konpdan25/Arduino_Spot_Welder_V4/DIY_SPOT_WELDER_V1/Reports/ERC/SCHEMATIC_CONNECTIVITY_CHECK.txt

DIY_SPOT_WELDER_V1 - schematic connectivity check (custom script, NOT KiCad ERC)
Netlist: Reports/Validation/DIY_SPOT_WELDER_V1_kicad7_export.net (kicad-cli 7.0.11 sch export netlist)

[1] Parity: kicad-cli exported netlist vs. design.py (on-board parts)
  nets compared: 64, on-board components: 133
  RESULT: PASS

[2] Rule checks on the full design (incl. off-board power assembly and PWR_FLAGs)
  nets checked: 75

SUMMARY: 0 error(s), 0 warning(s)
Note: a clean result proves netlist consistency only - it is NOT an electrical or safety approval.
