konpdan25/Arduino_Spot_Welder_V4/DIY_SPOT_WELDER_V1/Reports/DRC/DRC_REPORT_KiCad7.txt

** Drc report for /home/user/Arduino_Spot_Welder_V4/DIY_SPOT_WELDER_V1/KiCad/DIY_SPOT_WELDER_V1.kicad_pcb **
** Created on 2026-10-12 07:38:45 **

** Found 94 DRC violations **
[silk_overlap]: Silkscreen overlap
    Rule: board setup constraints silk; Severity: warning
    @(64.8648 mm, 130.7650 mm): Line on F.Silkscreen
    @(65.5750 mm, 132.7250 mm): Reference 'C3'
[silk_overlap]: Silkscreen overlap
    Rule: board setup constraints silk; Severity: warning
    @(64.9048 mm, 130.7650 mm): Line on F.Silkscreen
    @(65.5750 mm, 132.7250 mm): Reference 'C3'
[silk_overlap]: Silkscreen overlap
    Rule: board setup constraints silk; Severity: warning
    @(64.9448 mm, 130.7650 mm): Line on F.Silkscreen
    @(65.5750 mm, 132.7250 mm): Reference 'C3'
[silk_overlap]: Silkscreen overlap
    Rule: board setup constraints silk; Severity: warning
    @(64.9848 mm, 130.7650 mm): Line on F.Silkscreen
    @(65.5750 mm, 132.7250 mm): Reference 'C3'
[silk_overlap]: Silkscreen overlap
    Rule: board setup constraints silk; Severity: warning
    @(65.0248 mm, 130.7650 mm): Line on F.Silkscreen
    @(65.5750 mm, 132.7250 mm): Reference 'C3'
[silk_overlap]: Silkscreen overlap
    Rule: board setup constraints silk; Severity: warning
    @(65.0648 mm, 130.7650 mm): Line on F.Silkscreen
    @(65.5750 mm, 132.7250 mm): Reference 'C3'
[silk_overlap]: Silkscreen overlap
    Rule: board setup constraints silk; Severity: warning
    @(65.1048 mm, 130.7650 mm): Line on F.Silkscreen
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
    @(234.9800 mm, 68.1900 mm): PTH pad 2 [GND] of J3
[starved_thermal]: Thermal relief connection to zone incomplete (zone min spoke count 2; actual 1)
    Local override; Severity: error
    @(50.6000 mm, 50.6000 mm): Zone [GND] on B.Cu
    @(131.5850 mm, 121.7750 mm): PTH pad 2 [GND] of C16
[starved_thermal]: Thermal relief connection to zone incomplete (zone min spoke count 2; actual 1)
    Local override; Severity: error
    @(50.6000 mm, 50.6000 mm): Zone [GND] on B.Cu
    @(131.5850 mm, 165.2250 mm): PTH pad 2 [GND] of C20
[starved_thermal]: Thermal relief connection to zone incomplete (zone min spoke count 2; actual 1)
    Local override; Severity: error
    @(50.6000 mm, 50.6000 mm): Zone [GND] on F.Cu
    @(131.5850 mm, 126.0250 mm): PTH pad 2 [GND] of C18
[starved_thermal]: Thermal relief connection to zone incomplete (zone min spoke count 2; actual 1)
    Local override; Severity: error
    @(50.6000 mm, 50.6000 mm): Zone [GND] on F.Cu
    @(199.1950 mm, 68.2450 mm): PTH pad 5 [GND] of U4
[silk_edge_clearance]: Silkscreen clipped by board edge
    Rule: board setup constraints silk; Severity: warning
    @(50.0000 mm, 190.0000 mm): Line on Edge.Cuts
    @(50.0450 mm, 70.0050 mm): Reference 'J1'

** Found 1 unconnected pads **
[unconnected_items]: Missing connection between items
    Local override; Severity: error
    @(156.0300 mm, 184.9750 mm): Track [ENC_SW_RAW] on B.Cu, length 1.1769 mm
    @(113.0750 mm, 169.4750 mm): PTH pad 1 [ENC_SW_RAW] of R27

** Found 0 Footprint errors **

** End of Report **
