konpdan25/Arduino_Spot_Welder_V4/DIY_SPOT_WELDER_V1/Reports/Validation/CALCULATION_RESULTS.md

# Calculation results (generated by `Calculations/Engineering_Models/weld_calc.py`)

> All values are **estimates** derived from the parameter table. None are measurements.

## 1. Parameters

| Key | min | typ | max | unit | origin |
|---|---|---|---|---|---|
| bat_ocv | 12.4 | 12.7 | 12.9 | V | ASM  open-circuit voltage 75 %..100 % SoC |
| bat_rint | 0.025 | 0.032 | 0.045 | ohm | DS3 <=32 mOhm (full charge, 25 C, AC method); DC pulse value assumed up to 45 mOhm |
| bat_imax_ds | 70 | 70 | 70 | A | DS3 max discharge current 70 A for 5 s |
| car_rint | 0.004 | 0.006 | 0.009 | ohm | ASM  45-60 Ah, 400-600 A EN starter battery |
| len_batlead_m | 0.5 | 0.6 | 0.8 | m | ASM  total length battery(+)->assembly + assembly->battery(-) |
| len_weld_m | 0.8 | 1 | 1.2 | m | ASM  total length of both welding cables |
| cs_cable_mm2 | 16 | 16 | 16 | mm2 | ASM  16 mm2 fine-stranded silicone (as reference) |
| r_tips | 0.0001 | 0.00015 | 0.00025 | ohm | ASM  2 solid Cu electrodes ~40 mm, 10 mm2 |
| n_joints | 6 | 8 | 10 | - | ASM  bolted/crimped joints in the loop |
| r_joint | 5e-05 | 0.0001 | 0.0002 | ohm | ASM  per clean crimp/bolt joint |
| r_fuse | 0.0003 | 0.00045 | 0.0007 | ohm | ASM  ANL/MIDI 100-150 A cold resistance (verify with fuse datasheet) |
| r_relay | 0.0002 | 0.0006 | 0.0015 | ohm | ASM  unknown used 100 A relay contacts (MUST be measured) |
| r_disconnect | 0.0001 | 0.00015 | 0.0003 | ohm | ASM  battery isolator switch |
| r_weld | 0.0005 | 0.0015 | 0.003 | ohm | ASM  electrode-Ni-cell contact + Ni path; falls during the weld |
| n_fet | 6 | 6 | 6 | - | STOCK at least 6 x IRLZ44N |
| rds_25 | 0.022 | 0.022 | 0.022 | ohm | DS  RDS(on) max at VGS=10 V, ID=25 A, Tj=25 C |
| rds_tc | 1.45 | 1.6 | 1.75 | x | DS  normalised RDS(on) at Tj~125 C read from curve (approx.) |
| share | 1.1 | 1.2 | 1.3 | x | ASM  worst-device current share factor for 6 parallel TO-220 |
| r_fet_leads | 5e-05 | 8e-05 | 0.00012 | ohm | ASM  per device leads+solder to busbar |
| fet_idm | 160 | 160 | 160 | A | DS  pulsed drain current |
| fet_rthjc | 1.8 | 1.8 | 1.8 | K/W | DS  RthJC TO-220 (IRLZ44N) |
| zth_tau | 0.4 | 0.3 | 0.2 | s | ASM  Zth(t) ~ RthJC*sqrt(t/tau) (min=best); fit to typical TO-220 curves, verify on real datasheet |
| tj_limit | 150 | 150 | 150 | C | DESIGN derated junction limit for repetitive pulses |
| fet_tjmax | 175 | 175 | 175 | C | DS |
| t_case | 35 | 50 | 65 | C | ASM  drain busbar/heatsink temperature |
| l_weld | 4e-07 | 9e-07 | 1.5e-06 | H | ASM  welding cables (kept together vs. open loop) |
| l_bat | 1e-07 | 2e-07 | 4e-07 | H | ASM  battery leads, twisted, short |
| c_logic_uF | 7200 | 9000 | 10800 | uF | STOCK 6800 uF + 2200 uF / 25 V, +-20 % |
| c_relay_uF | 11760 | 14700 | 17640 | uF | STOCK 10000 uF + 4700 uF / 25 V, +-20 % |
| i_logic | 0.06 | 0.08 | 0.11 | A | ASM  Nano ~25 mA + OLED 20 mA + 7805/LDO Iq + LM393 + TC4422 Iq + LEDs |
| i_relay | 0.27 | 0.3 | 0.33 | A | USER ~300 mA relay coil at 12 V |
| r_tap | 1.5 | 1.5 | 1.5 | ohm | DESIGN inrush/limit resistor in supply tap |
| vf_supply | 0.35 | 0.45 | 0.55 | V | DS  SB560/1N5822-class Schottky at ~0.4 A |
| uvlo_th | 7.8 | 8 | 8.2 | V | DESIGN gate-drive UVLO threshold |
| v_7805_min_in | 7 | 7 | 7 | V | DS  7805 min input at light load (Vout+2 V) |
| pl_R | 67320 | 68000 | 68680 | ohm | DESIGN 1 % |
| pl_C | 8e-07 | 1e-06 | 1.1e-06 | F | DESIGN 1 uF X7R 50 V 1206, incl. DC-bias derating |
| pl_voh | 4.6 | 4.8 | 5 | V | DS  ATmega328P VOH at ~1 mA, VCC 4.8-5.2 V |
| fw_max_on_ms | 50 | 50 | 50 | ms | DESIGN firmware hard limit for one ON interval |

## 2. Loop resistance budget (mOhm)

| Element | best | typ | worst |
|---|---|---|---|
| battery leads | 0.54 | 0.64 | 0.86 |
| welding cables | 0.86 | 1.07 | 1.29 |
| electrode tips | 0.10 | 0.15 | 0.25 |
| joints | 0.30 | 0.80 | 2.00 |
| fuse | 0.30 | 0.45 | 0.70 |
| relay contacts | 0.20 | 0.60 | 1.50 |
| disconnect | 0.10 | 0.15 | 0.30 |
| MOSFETs (6x IRLZ44N, hot) | 5.33 | 5.88 | 6.44 |
| weld zone | 0.50 | 1.50 | 3.00 |
| **R_ext total** | **8.22** | **11.25** | **16.34** |

## 3. Weld current envelope

| Source | Case | R_source mOhm | R_ext mOhm | I_peak A | V_terminal during pulse V | P_weld-zone W | E_weld-zone in 10 ms J |
|---|---|---|---|---|---|---|---|
| RT1270 | best | 25.0 | 8.22 | 388 | 3.19 | 75 | 0.75 |
| RT1270 | typ | 32.0 | 11.25 | 294 | 3.30 | 129 | 1.29 |
| RT1270 | worst | 45.0 | 16.34 | 202 | 3.30 | 123 | 1.23 |
| Car battery (ref.) | best | 4.0 | 3.90 | 1633 | 6.37 | 1334 | 13.34 |
| Car battery (ref.) | typ | 6.0 | 6.37 | 1027 | 6.54 | 1581 | 15.81 |
| Car battery (ref.) | worst | 9.0 | 10.90 | 623 | 6.79 | 1165 | 11.65 |

Ratio of weld-zone power car/RT1270 (typ): **12.2x**. RT1270 typical current is **4.2x** the datasheet 70 A (5 s) maximum.

## 4. MOSFET single-pulse stress (6x IRLZ44N, worst-shared device)

Zth(t) = RthJC*sqrt(t/tau) capped at RthJC (assumption). Current held constant (conservative).

| Total current A | Case | T_case C | I per device A | IDM margin | Tj after 20 ms | Tj after 50 ms | Tj after 100 ms | Max pulse for Tj<=150 C |
|---|---|---|---|---|---|---|---|---|
| 200 | best | 35 | 37 | 4.4x | 48 C | 56 C | 67 C | 1000 ms |
| 200 | typ | 50 | 40 | 4.0x | 71 C | 85 C | 104 C | 244 ms |
| 200 | worst | 65 | 43 | 3.7x | 102 C | 132 C | 178 C | 70 ms |
| 294 | best | 35 | 54 | 3.0x | 65 C | 87 C | 116 C | 165 ms |
| 294 | typ | 50 | 59 | 2.7x | 101 C | 146 C | 222 C | 53 ms |
| 294 | worst | 65 | 64 | 2.5x | 171 C | 326 C | runaway | 15 ms |
| 388 | best | 35 | 71 | 2.2x | 94 C | 144 C | 226 C | 54 ms |
| 388 | typ | 50 | 78 | 2.1x | 163 C | 320 C | runaway | 17 ms |
| 388 | worst | 65 | 84 | 1.9x | runaway | runaway | runaway | 5 ms |
| 450 | best | 35 | 82 | 1.9x | 121 C | 209 C | 393 C | 30 ms |
| 450 | typ | 50 | 90 | 1.8x | 239 C | runaway | runaway | 10 ms |
| 450 | worst | 65 | 98 | 1.6x | runaway | runaway | runaway | 3 ms |

Conclusion basis: the firmware ON-time limit must stay below the 'typ' max-pulse column at the expected current.

## 5. Average dissipation (repetition)

- One weld every 2 s, 65 ms total ON: 8.5 J/device/weld -> 4.3 W/device, 26 W total into the drain busbar/heatsink.
- One weld every 5 s, 65 ms total ON: 8.5 J/device/weld -> 1.7 W/device, 10 W total into the drain busbar/heatsink.
- One weld every 10 s, 65 ms total ON: 8.5 J/device/weld -> 0.9 W/device, 5 W total into the drain busbar/heatsink.

## 6. Inductive energy at turn-off

- I = 294 A: welding-cable energy 65 mJ (free-wheels through STPS3045CP), battery-lead energy 17 mJ (absorbed by 1000 uF + SMBJ24CA at the assembly bus).
- I = 388 A: welding-cable energy 113 mJ (free-wheels through STPS3045CP), battery-lead energy 30 mJ (absorbed by 1000 uF + SMBJ24CA at the assembly bus).
- Free-wheel time constant ~0.40 ms; I2t per diode die (2 dice share) ~7.6 A2s vs. 242 A2s for 220 A/10 ms half-sine (DS3 IFSM).

## 7. Control rail hold-up (diode-isolated banks)

Worst-case bank voltage before the pulse: 11.19 V (OCV min - Vf max - I*R_tap).

| Rail | C used uF (min) | Load A (max) | ON time ms | Droop V | End voltage V | Limit |
|---|---|---|---|---|---|---|
| Logic + gate drive | 7200 | 0.11 | 65 | 0.99 | 10.20 | UVLO 8.2 V, 7805 7.0 V |
| Relay coil | 11760 | 0.33 | 65 | 1.82 | 9.37 | relay drop-out voltage UNKNOWN |
| Logic + gate drive | 7200 | 0.11 | 96 | 1.47 | 9.72 | UVLO 8.2 V, 7805 7.0 V |
| Relay coil | 11760 | 0.33 | 96 | 2.69 | 8.50 | relay drop-out voltage UNKNOWN |

(65 ms = firmware maximum ON time: 50 ms main + 15 ms pre-pulse; second row = upper bound of the hardware limiter per ON interval.)

Inrush at connection: peak 8.6 A, energy in R_tap 2.37 J, I2t 1.58 A2s (choose a T3.15 A fuse with I2t >> this value).

## 8. Hardware pulse-length limiter window (Monte-Carlo, 20 000 samples)

R = 68 kOhm 1 %, C = 1 uF (-20/+10 %), Vth = VCC x 22k/(10k+22k), VCC 4.8-5.2 V, VOH VCC-0..0.2 V, LM393 Vos 5 mV.

- Hardware limit: min **63 ms**, median 78 ms, max **96 ms**.
- Firmware limit per ON interval: 50 ms -> margin to HW minimum 13 ms.

## 9. ADC scaling

- VBAT / VELEC / VDRV / VHOLD / VDRAIN: divider 33k/10k, k = 4.30; full scale 21.5 V at AVCC=5 V (21.0 mV/LSB), 4.73 V with the 1.1 V internal reference (4.6 mV/LSB); source impedance 7.7 kOhm.
- V_DS at typical current: 1723 mV -> current estimate from V_DS has +-30 % uncertainty (RDS(T) spread). It is an indication, not a measurement.

## 10. Cable adiabatic short-circuit withstand

- 10 mm2: I2t = 1.32 MA2s -> 9 s at 388 A
- 16 mm2: I2t = 3.39 MA2s -> 22 s at 388 A
- 25 mm2: I2t = 8.27 MA2s -> 55 s at 388 A

Weld-pulse I2t through the main fuse (best case 388 A, 65 ms): 9.8 kA2s per weld -> compare with the fuse's PRE-ARCING I2t (datasheet); require pre-arc I2t >= 5x pulse I2t to avoid fatigue.
