konpdan25/Arduino_Spot_Welder_V4/DIY_SPOT_WELDER_V1/Reports/Validation/DIY_SPOT_WELDER_V1_schematic.pdf

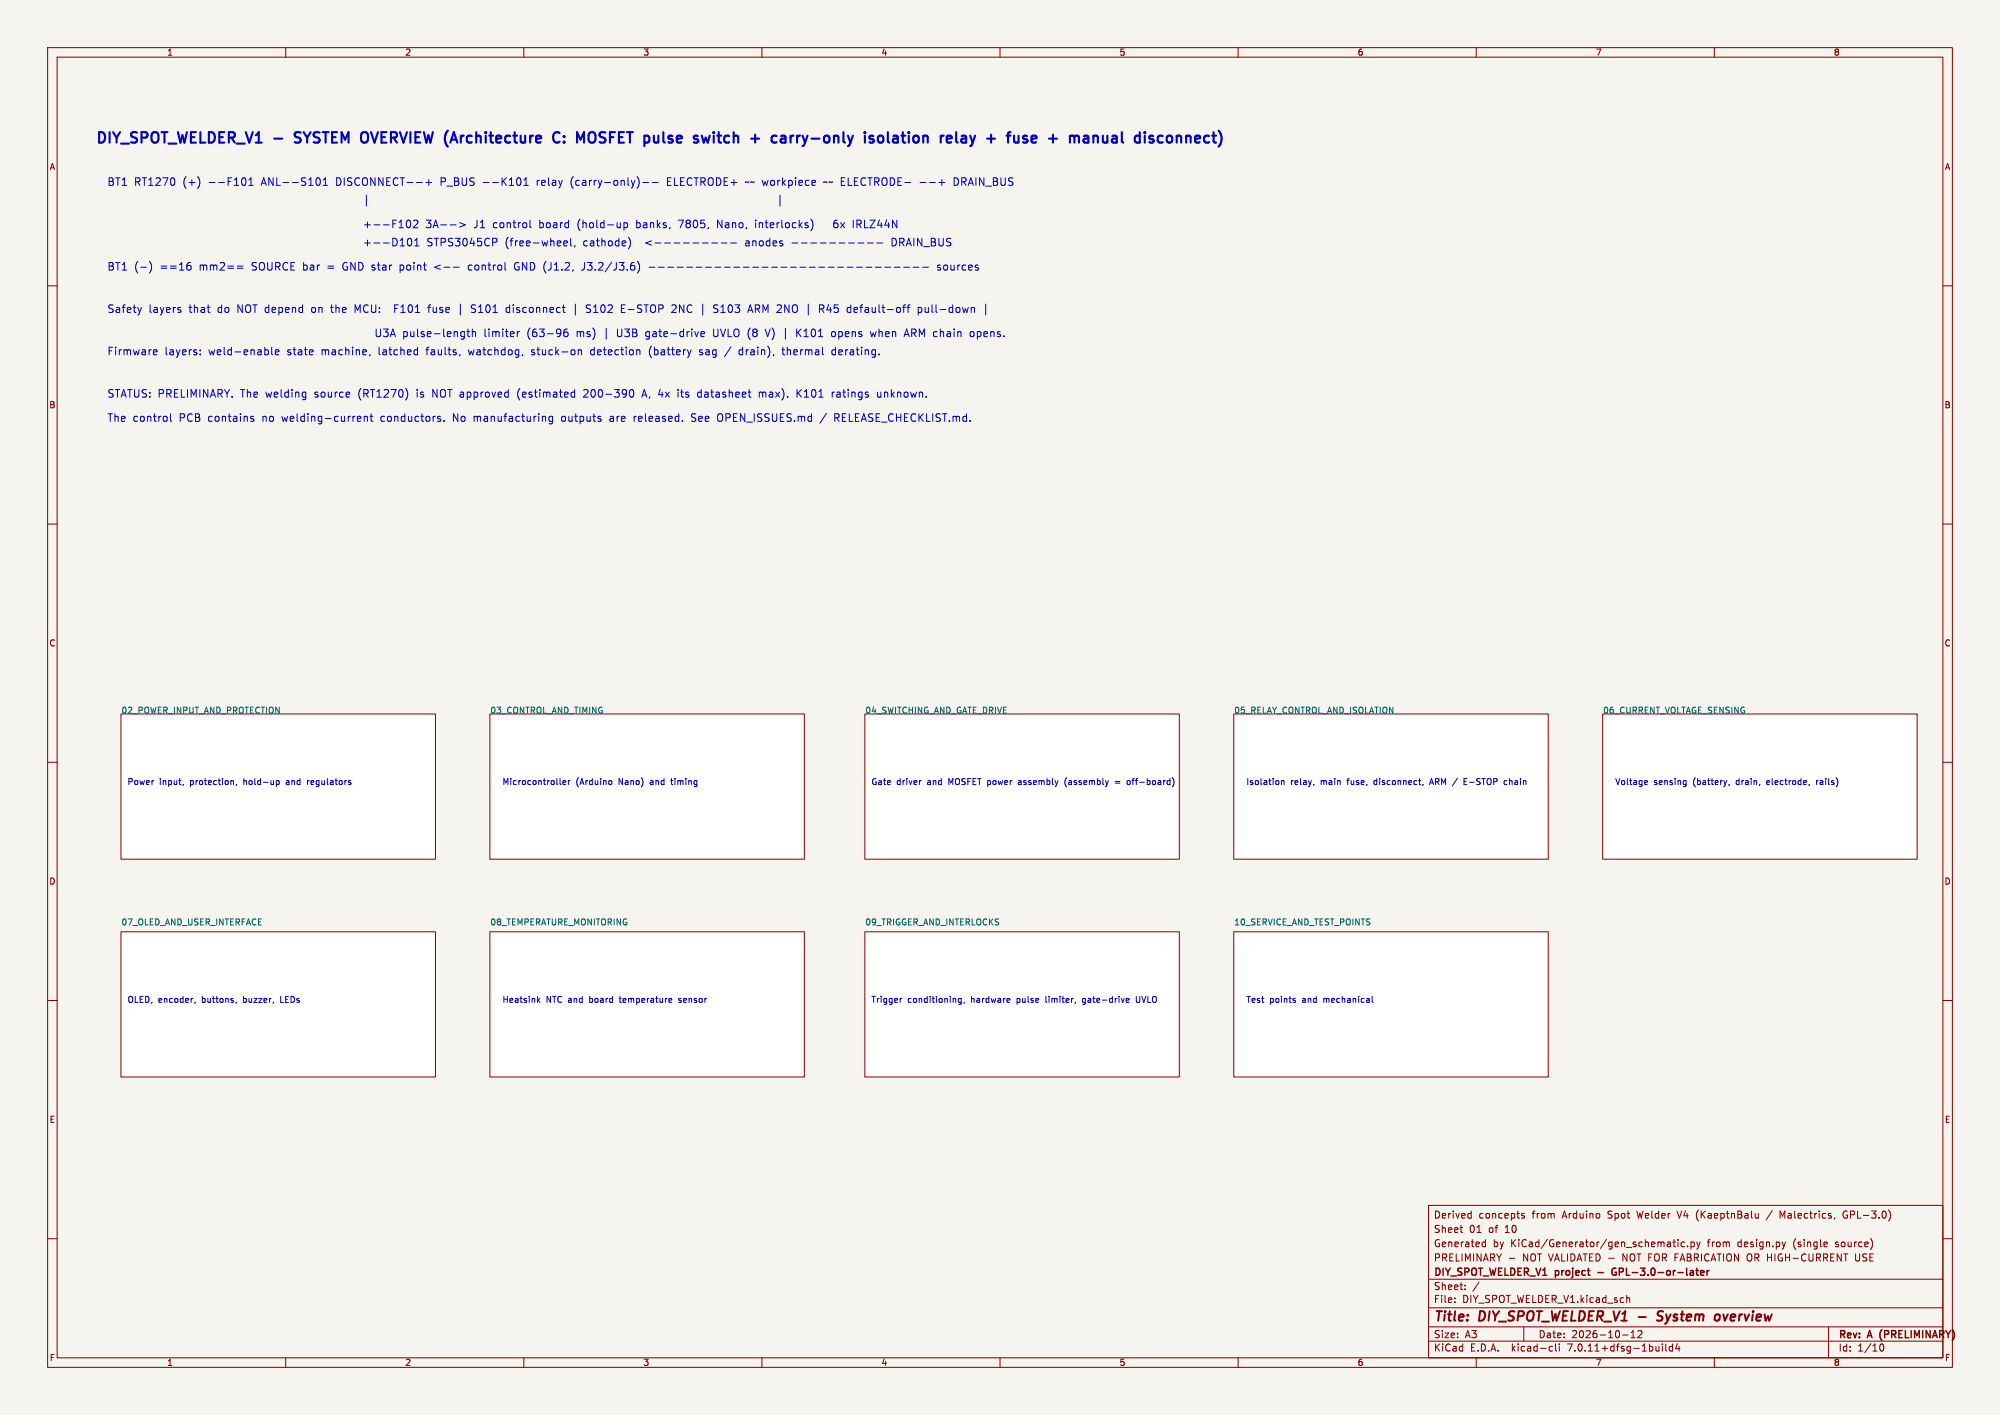
[picture p1: page 1]

Id: 1/10 Title: DIY_SPOT_WELDER_V1 - System overview

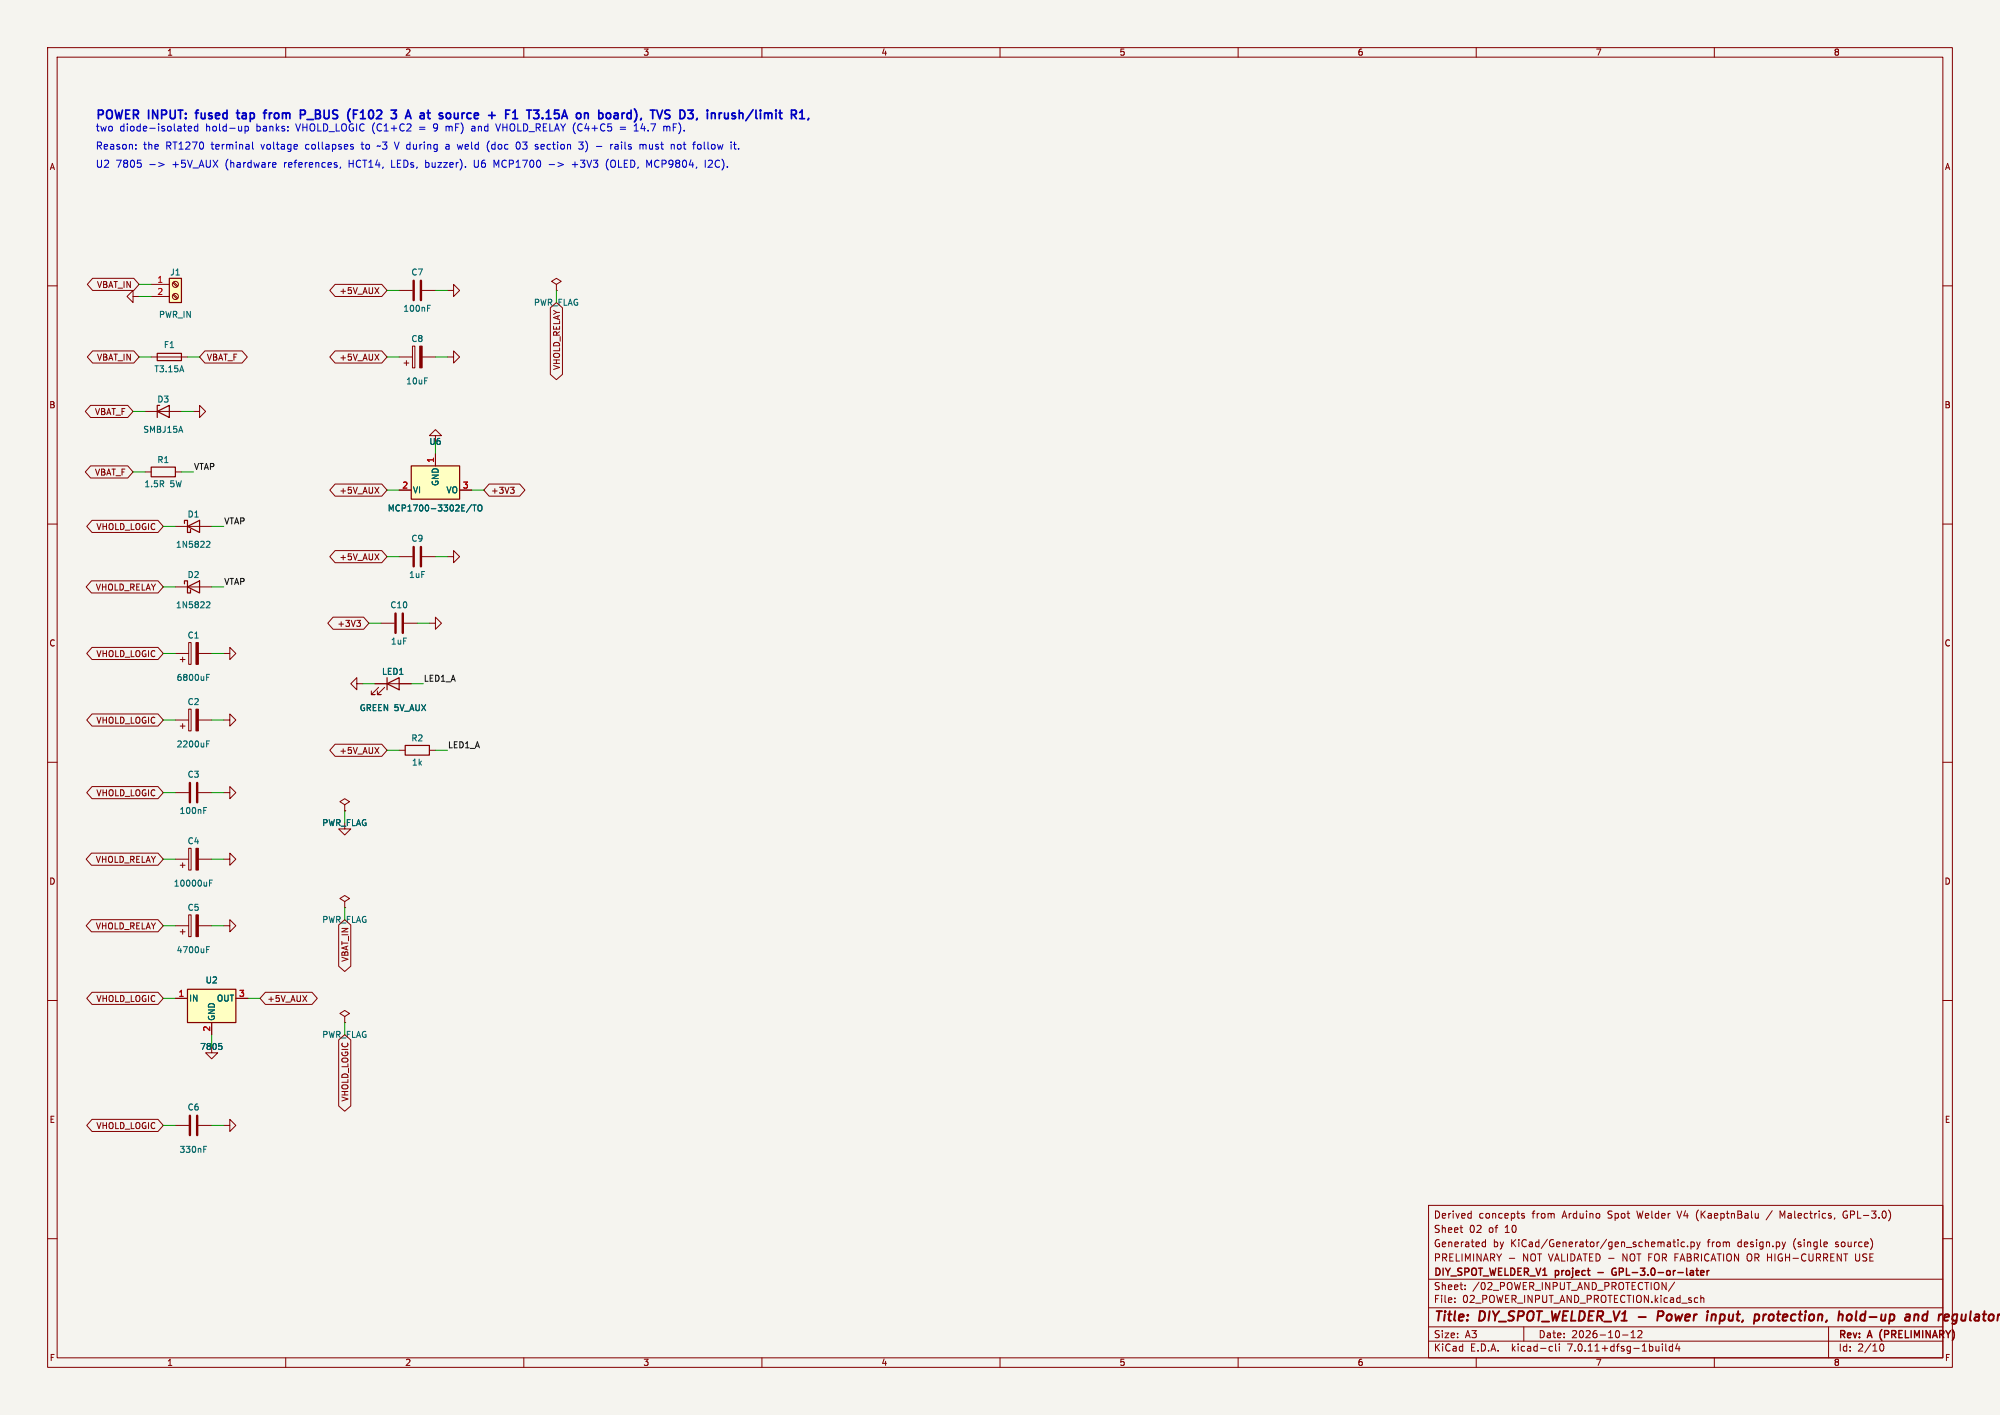
[picture p2: page 2]

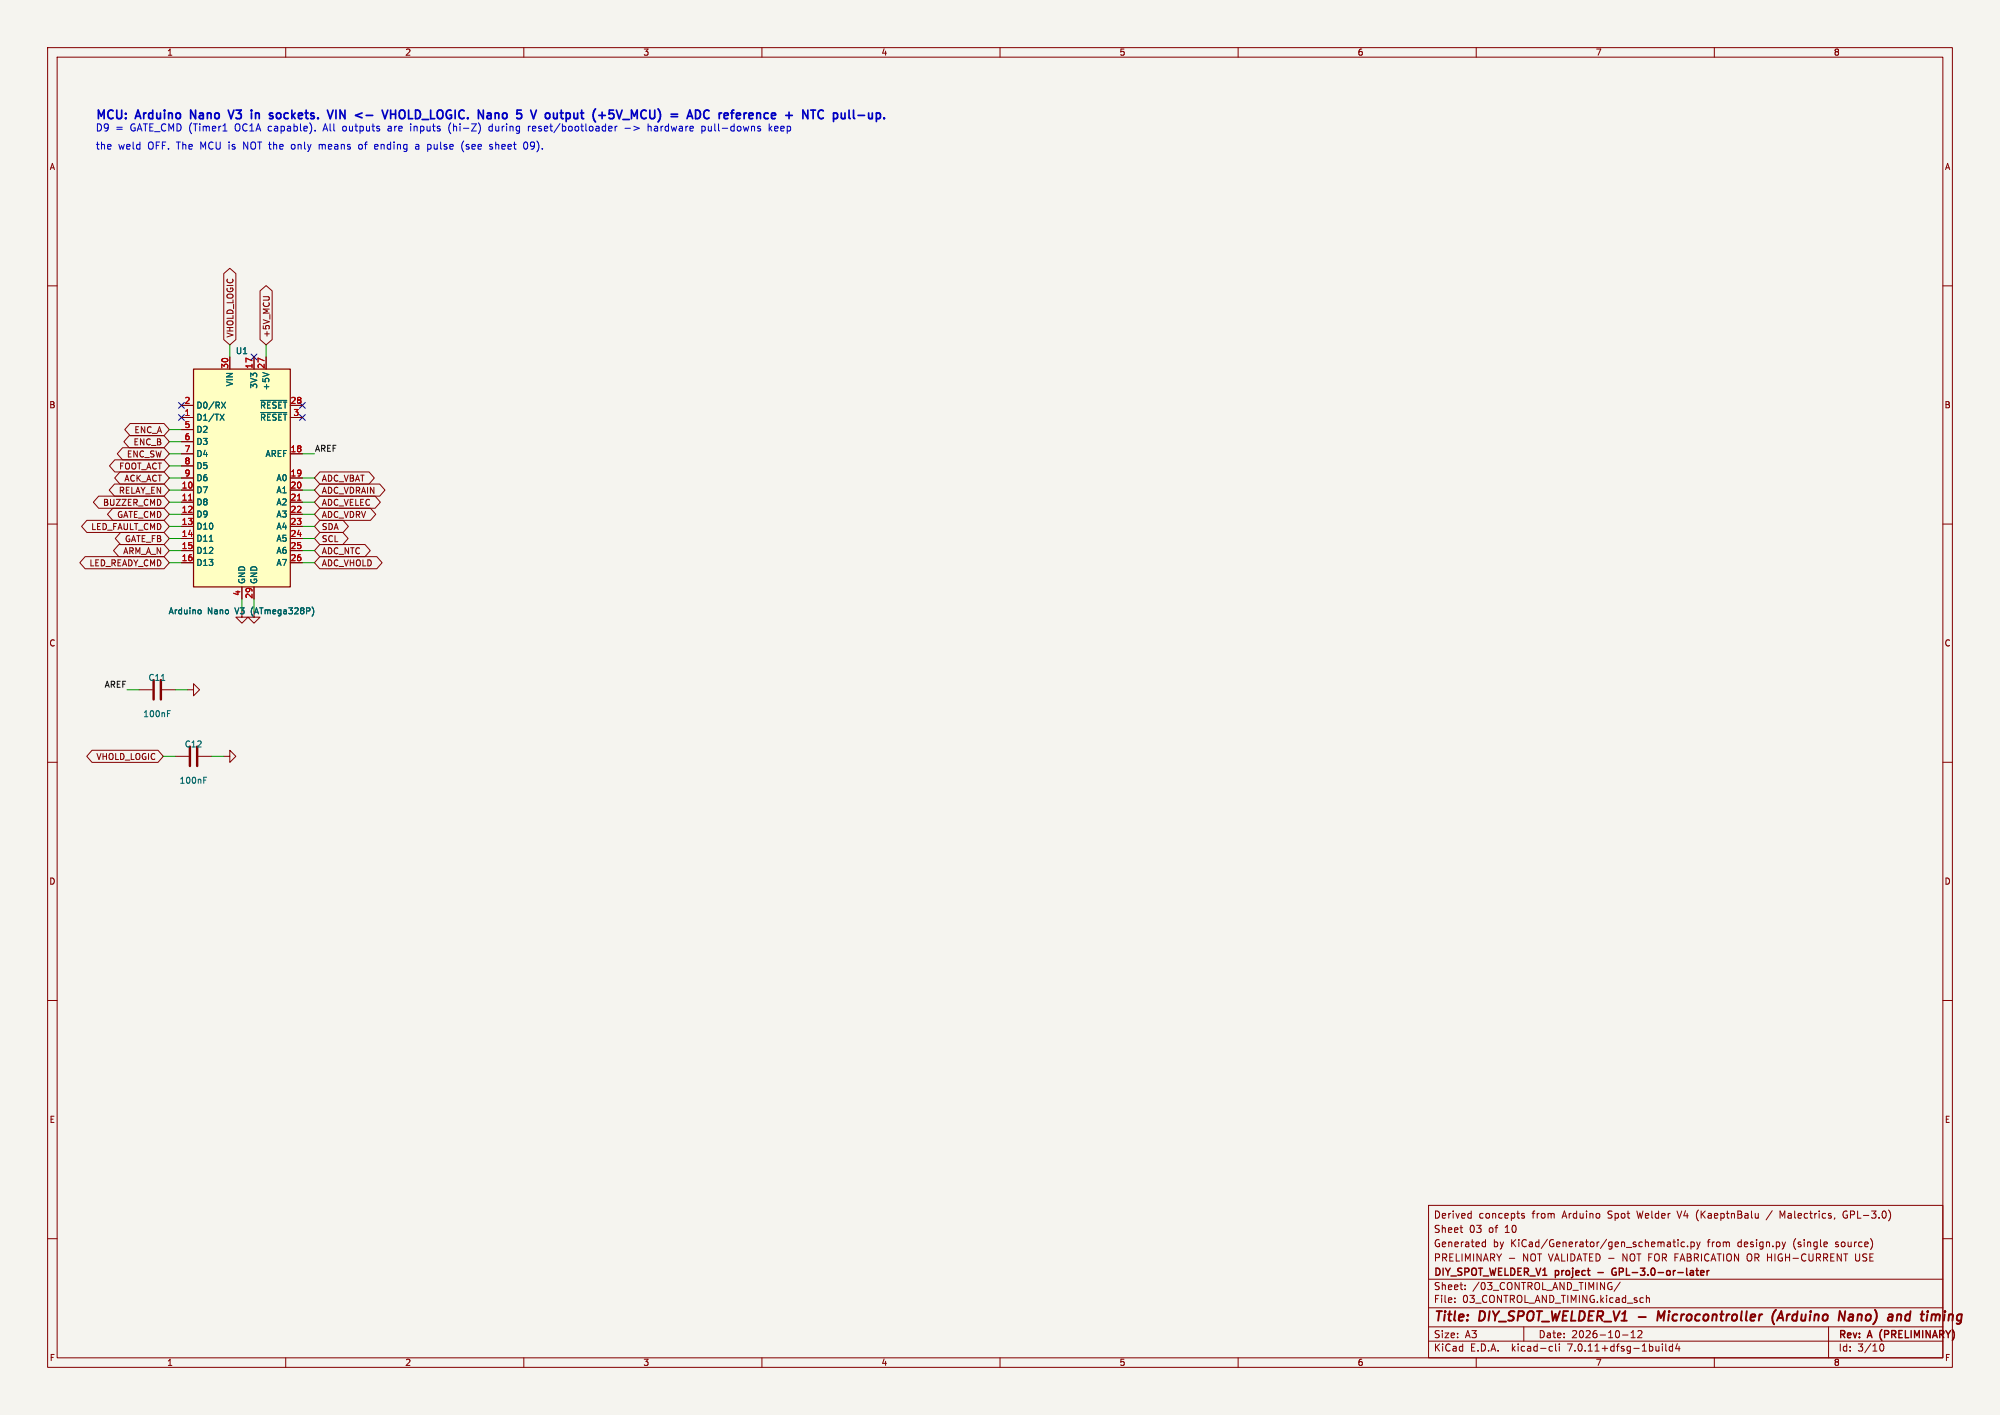
[picture p3: page 3]

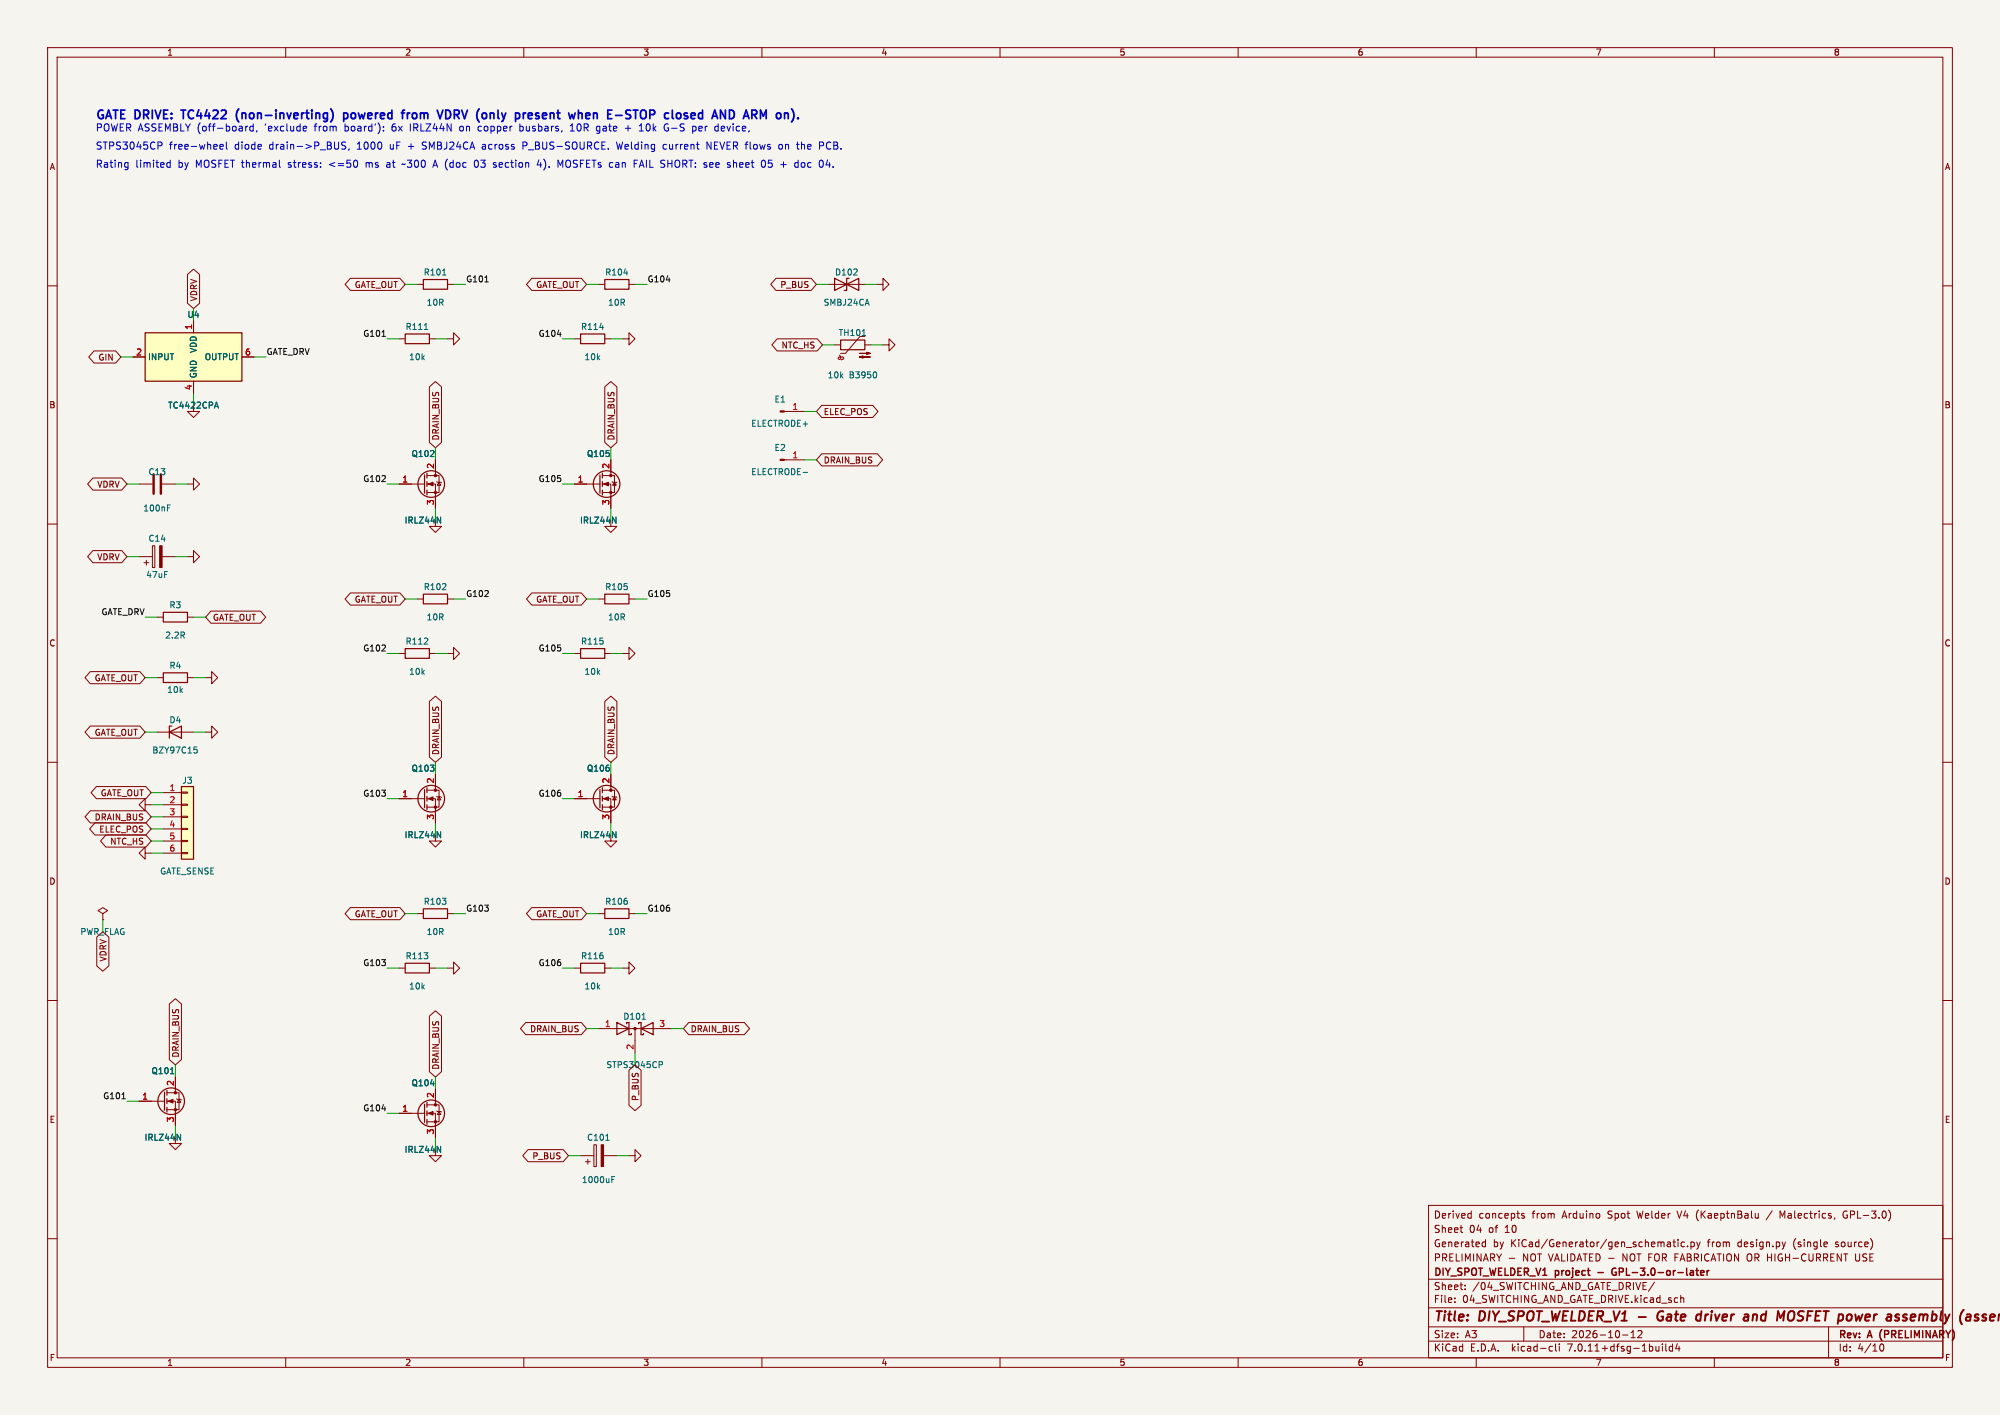
[picture p4: page 4]

Id: 4/10 Title: DIY_SPOT_WELDER_V1 - Gate driver and MOSFET power assembly (assembly = off-board) File: 04_SWITCHING_AND_GATE_DRIVE.kicad_sch Sheet: /04_SWITCHING_AND_GATE_DRIVE/

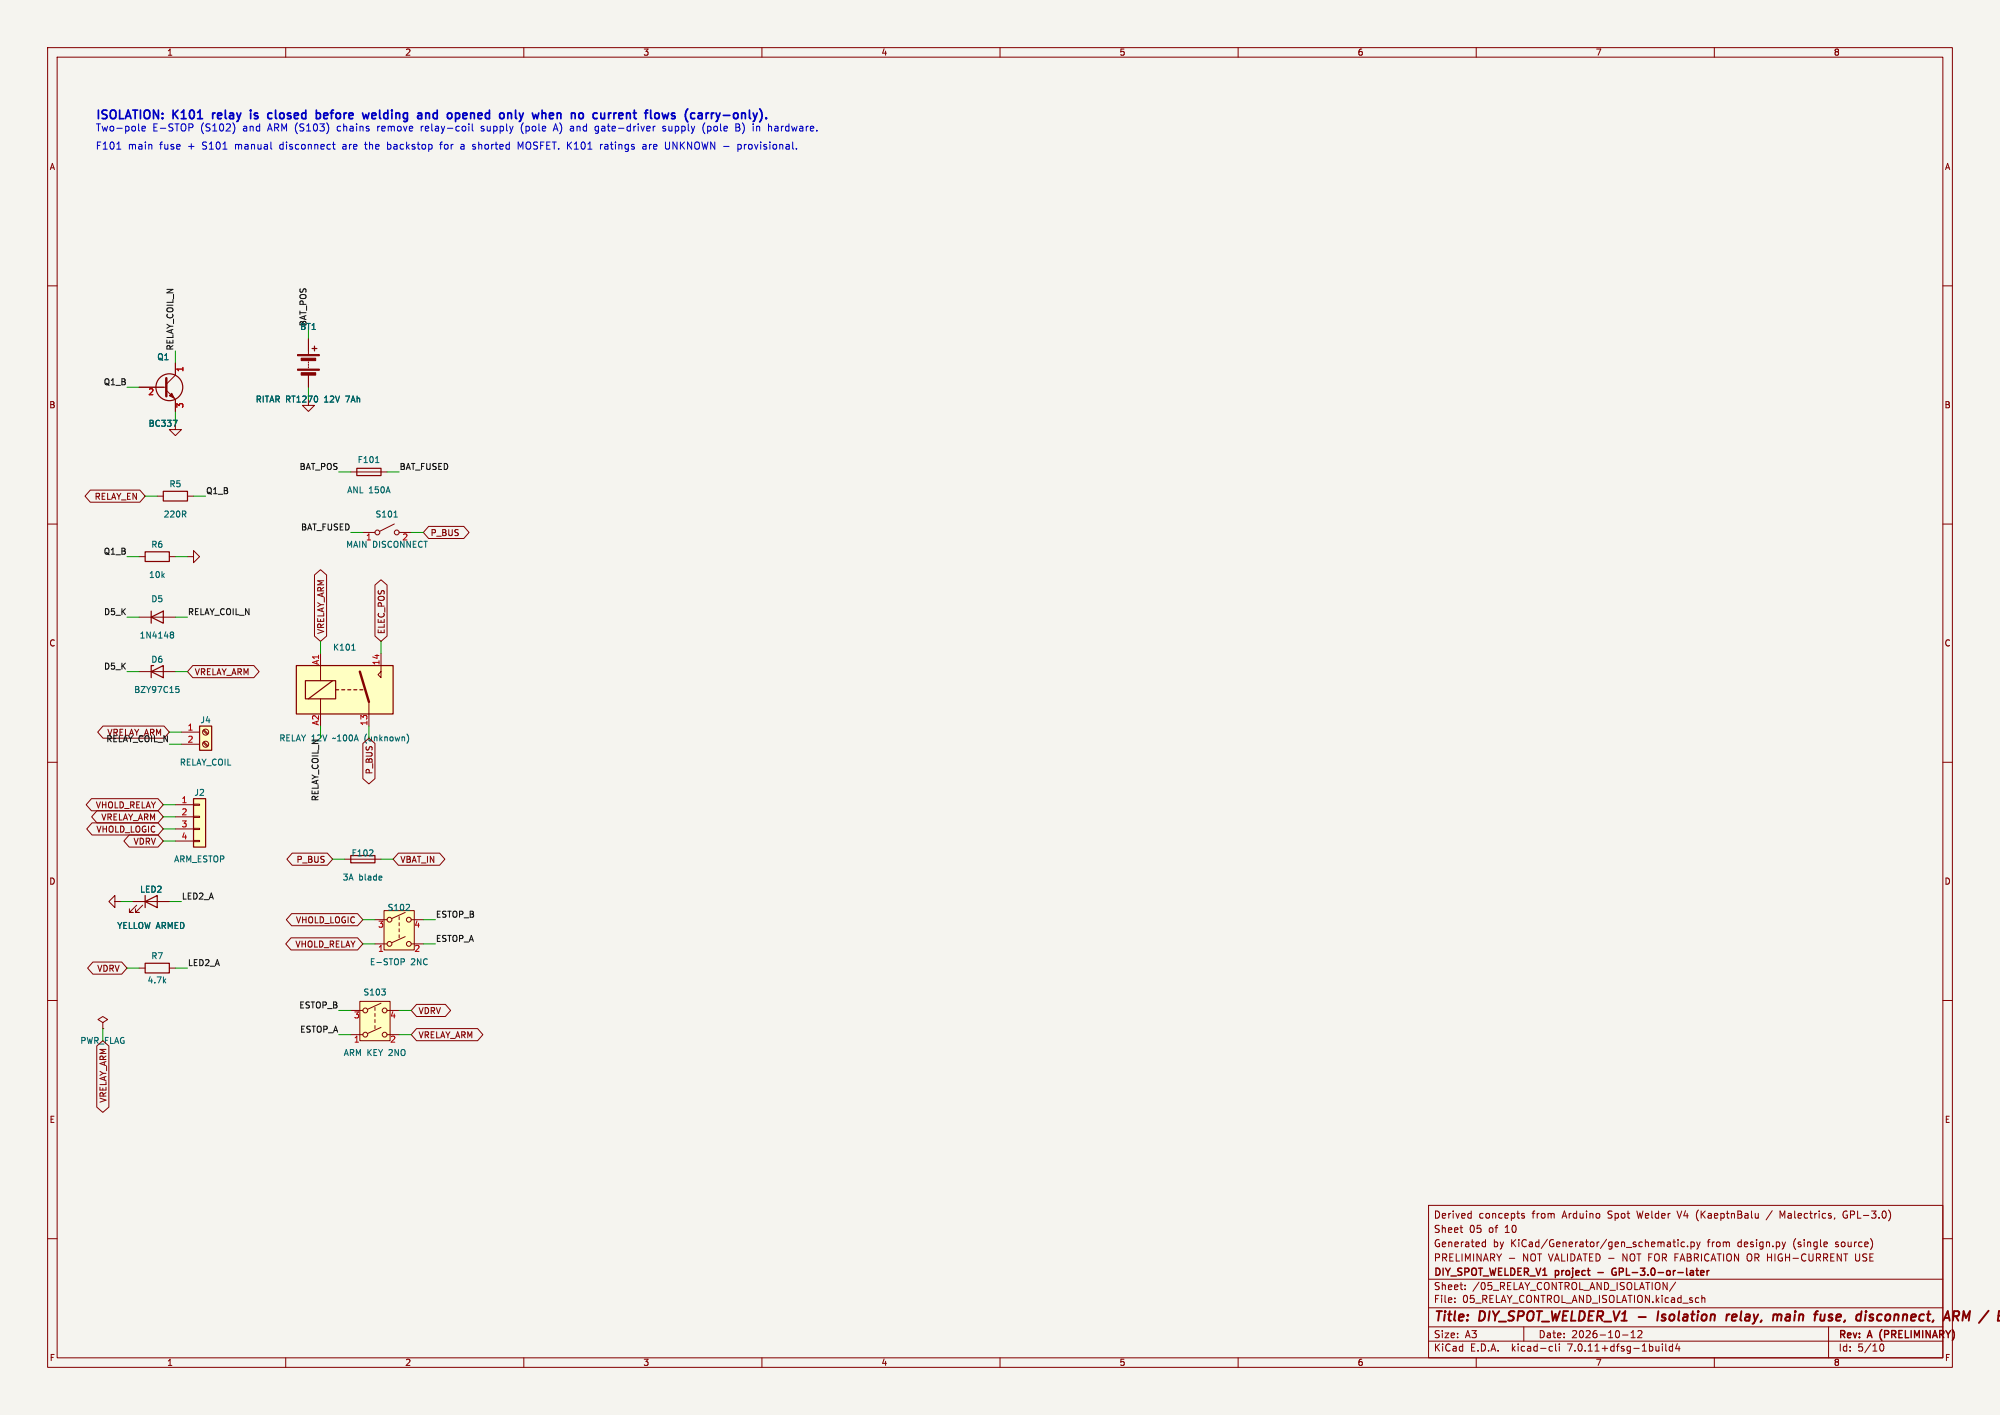
[picture p5: page 5]

File: 05_RELAY_CONTROL_AND_ISOLATION.kicad_sch Sheet: /05_RELAY_CONTROL_AND_ISOLATION/
Id: 5/10 Title: DIY_SPOT_WELDER_V1 - Isolation relay, main fuse, disconnect, ARM / E-STOP chain

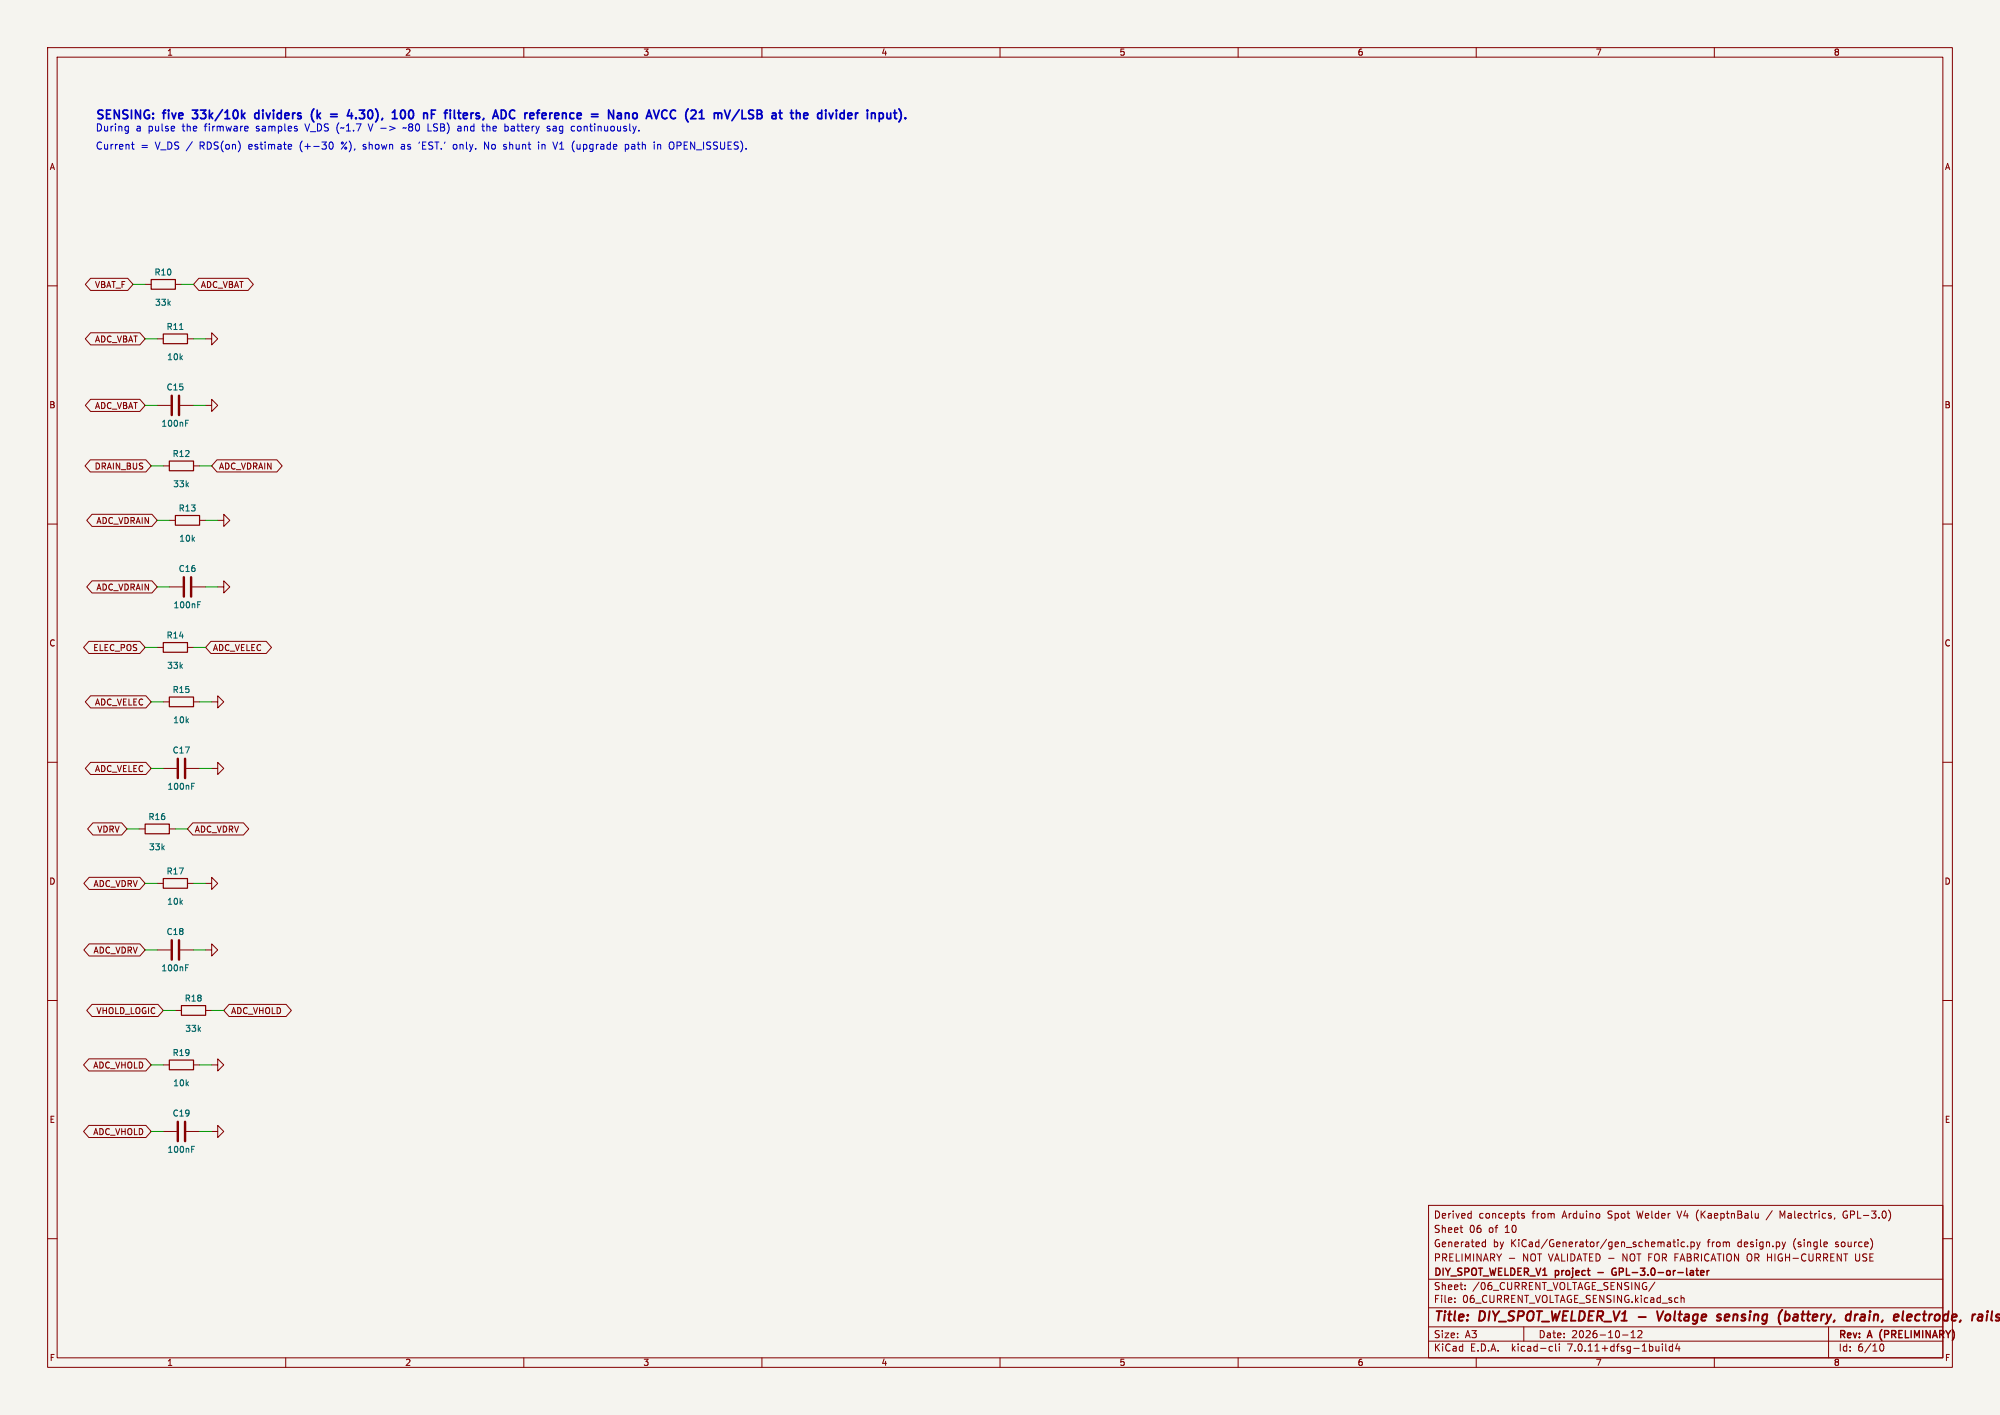
[picture p6: page 6]

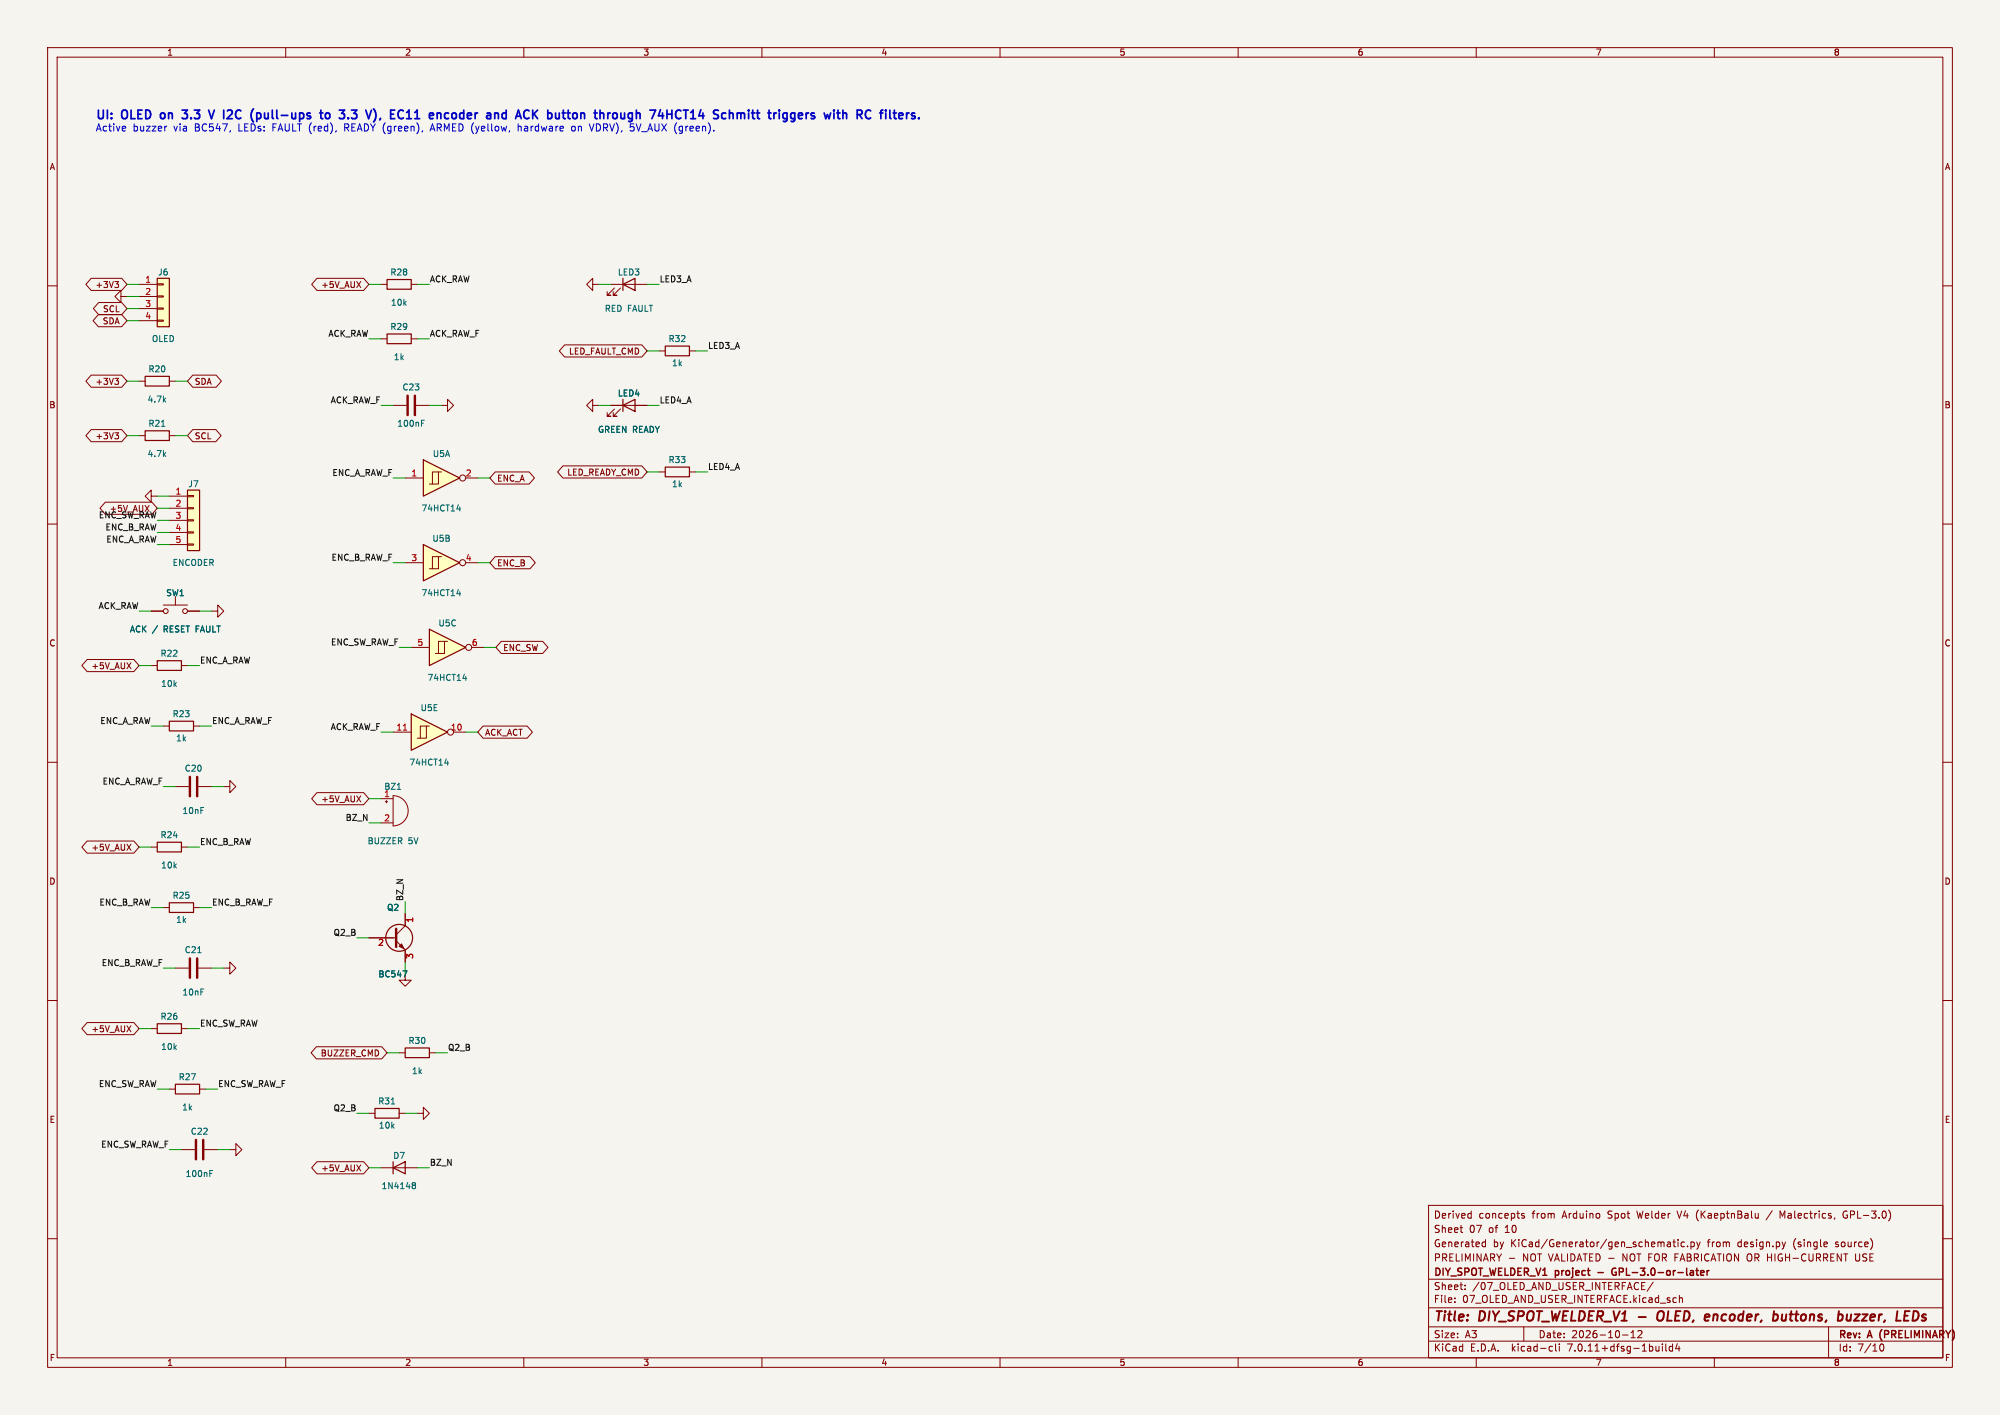
[picture p7: page 7]

Active buzzer via BC547, LEDs: FAULT (red), READY (green), ARMED (yellow, hardware on VDRV), 5V_AUX (green).

File: 07_OLED_AND_USER_INTERFACE.kicad_sch Sheet: /07_OLED_AND_USER_INTERFACE/
Id: 7/10 Title: DIY_SPOT_WELDER_V1 - OLED, encoder, buttons, buzzer, LEDs

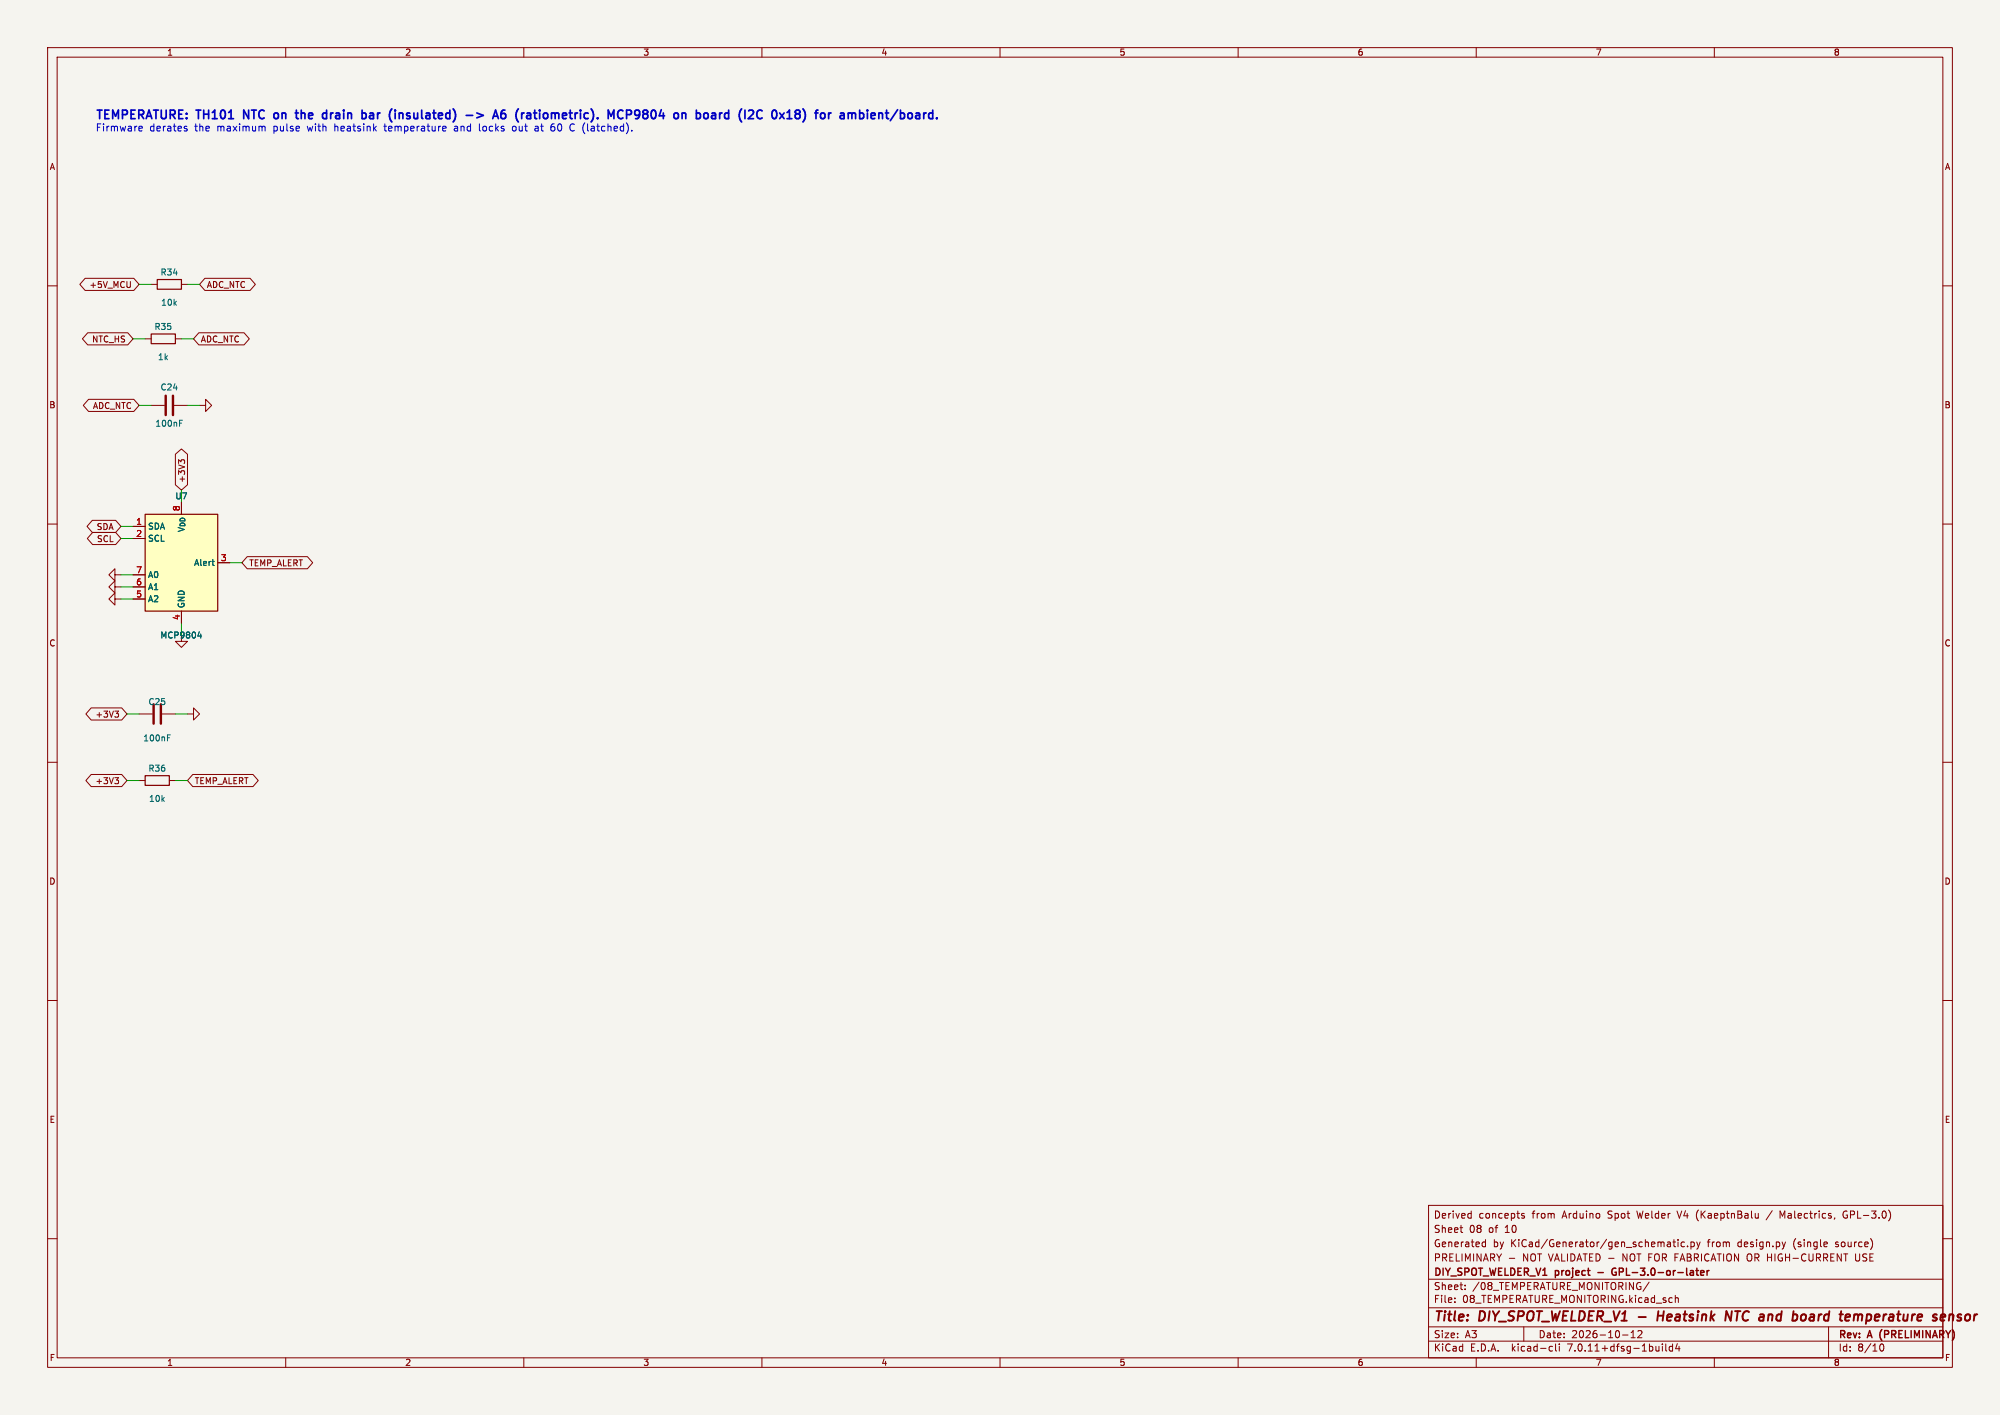
[picture p8: page 8]

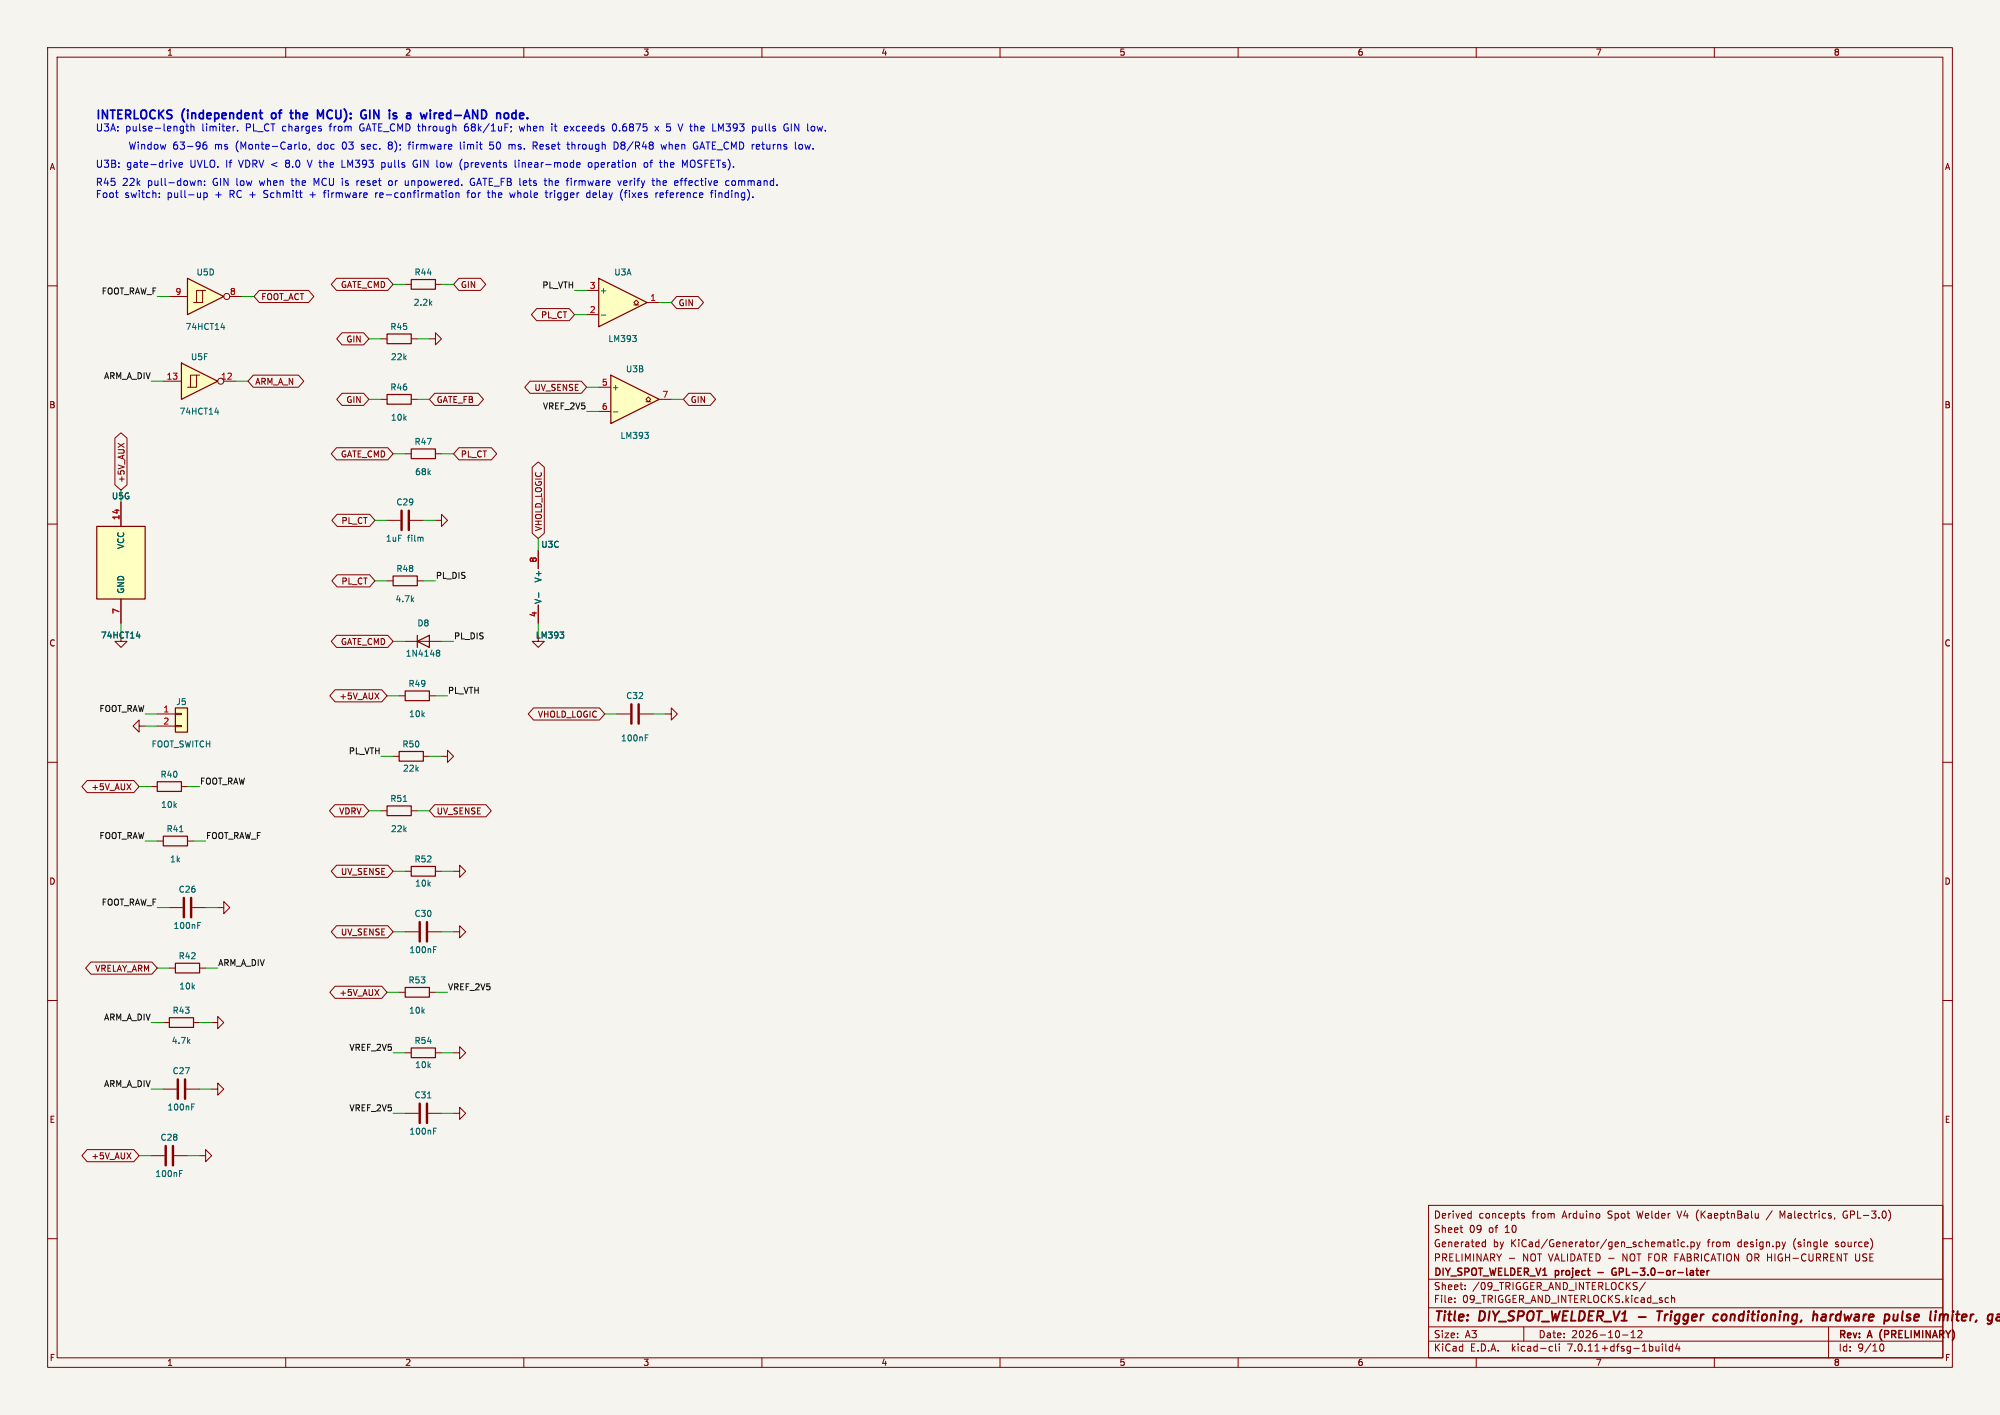
[picture p9: page 9]

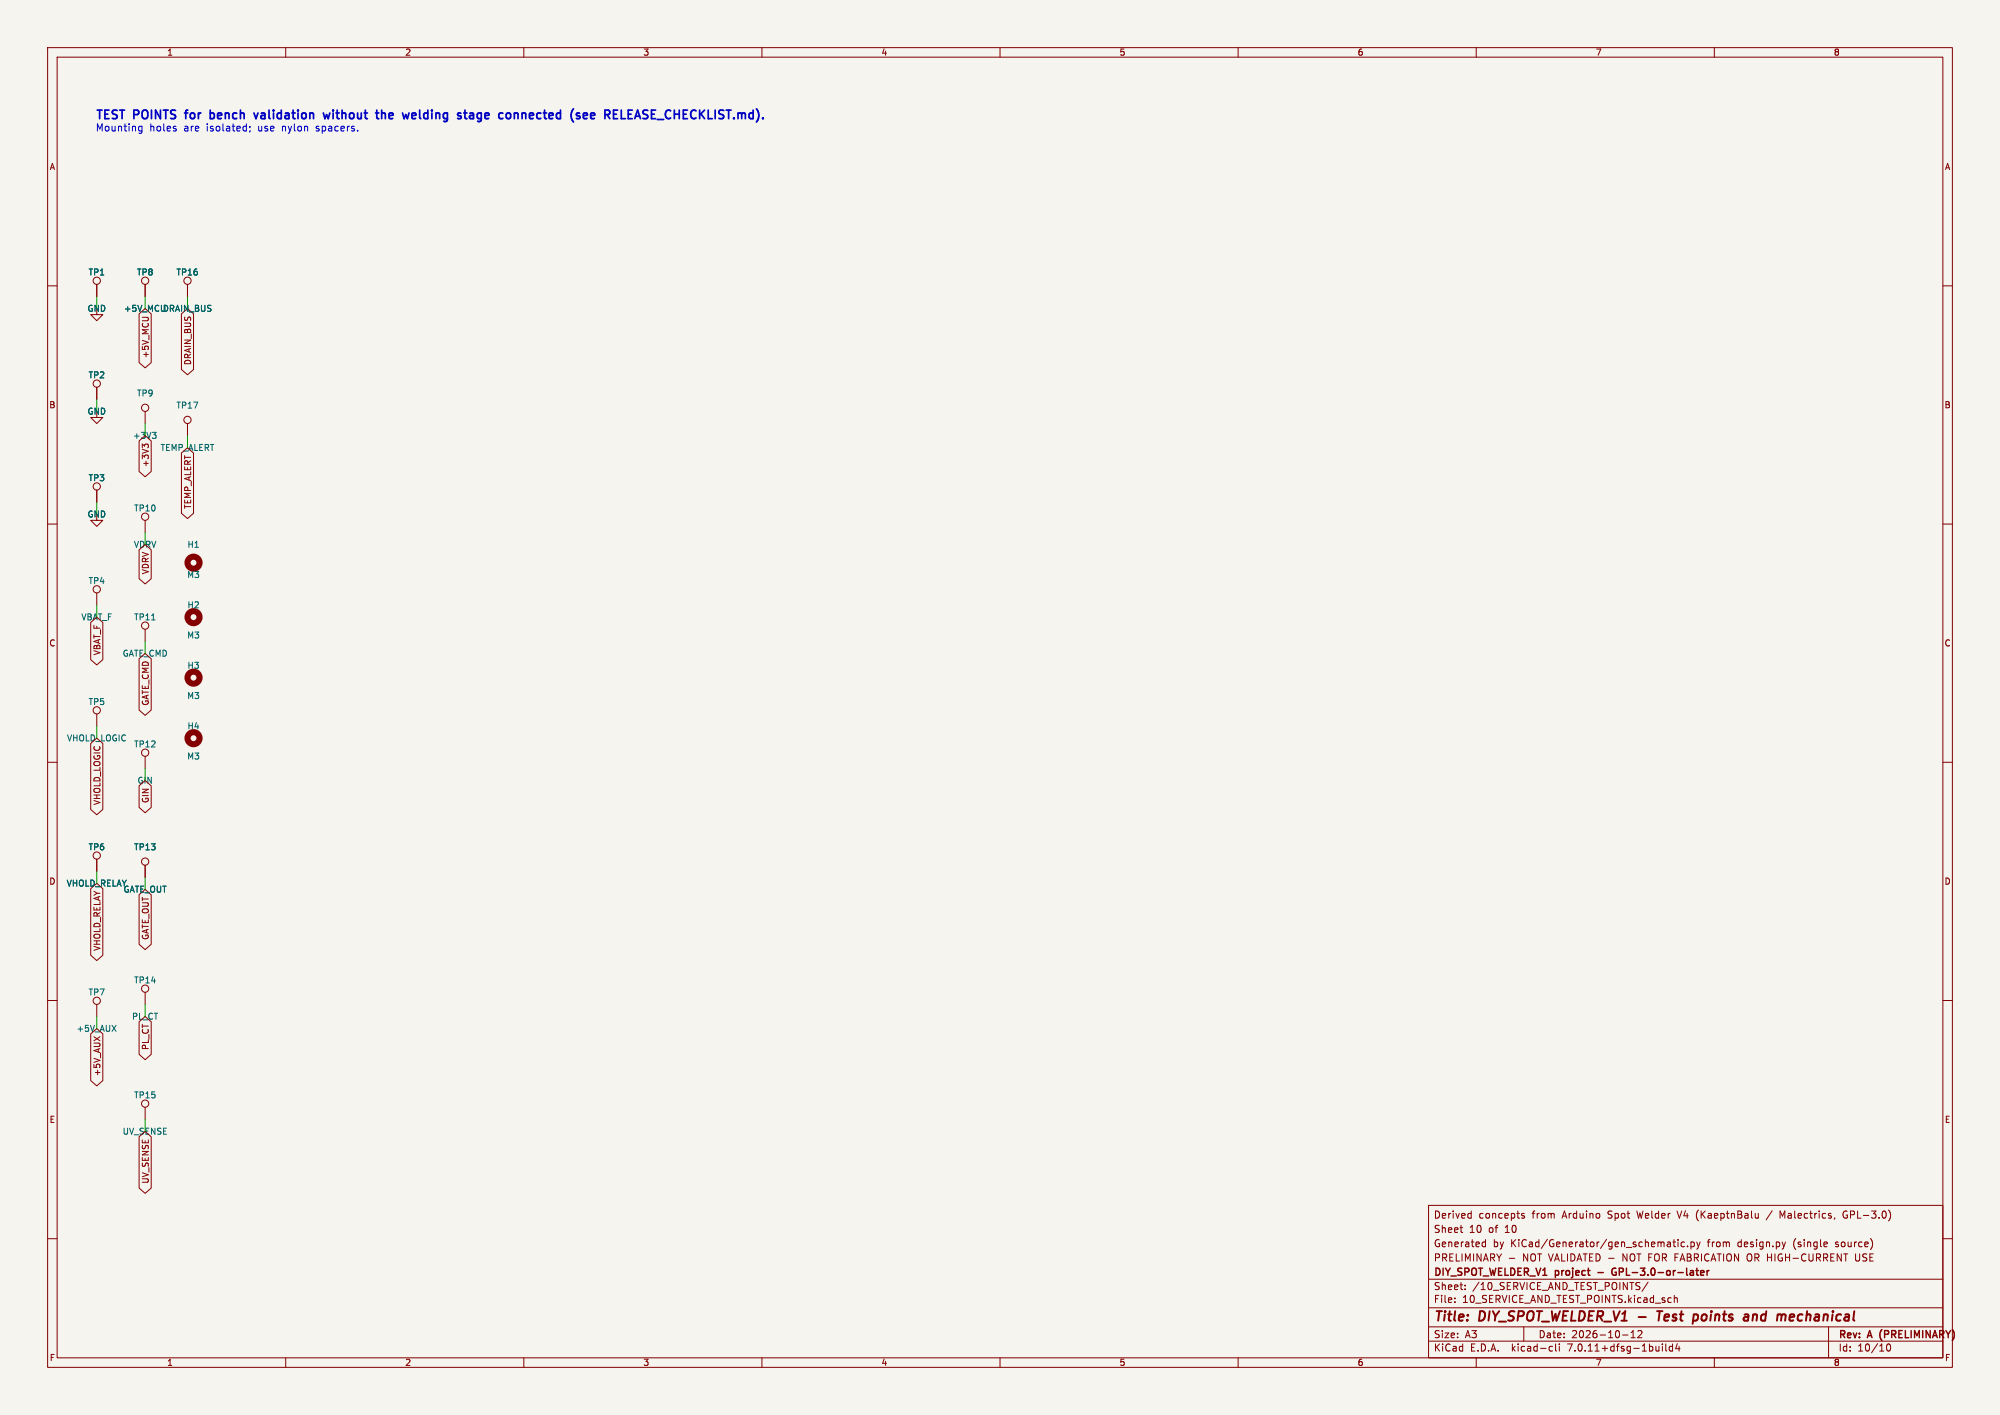
[picture p10: page 10]

Id: 10/10 Title: DIY_SPOT_WELDER_V1 - Test points and mechanical File: 10_SERVICE_AND_TEST_POINTS.kicad_sch Sheet: /10_SERVICE_AND_TEST_POINTS/
