konpdan25/Arduino_Spot_Welder_V4/DIY_SPOT_WELDER_V1/KiCad/DIY_SPOT_WELDER_V1.kicad_pcb

## KiCad design DIY_SPOT_WELDER_V1/KiCad/DIY_SPOT_WELDER_V1.kicad_pcb (2026-10-12)

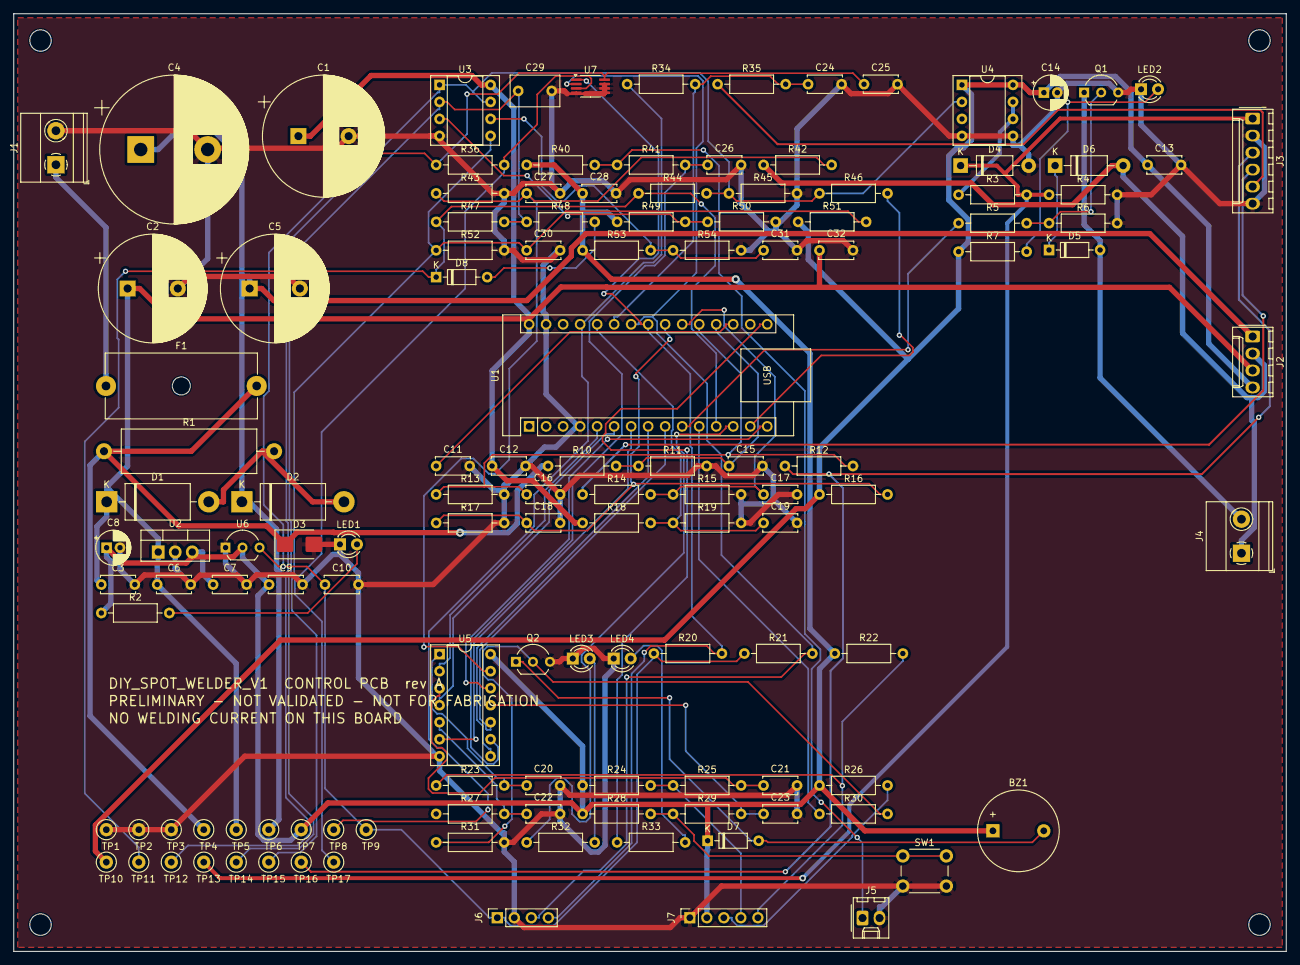
[picture p11: board DIY_SPOT_WELDER_V1.kicad_pcb from above]

Board: 2 copper layers, 190.0 x 140.0 mm, 133 parts (0 on the bottom side), 64 nets.

Parts:
BZ1: BUZZER 5V; Buzzer_12x9.5RM7.6
C1: 6800uF; CP_Radial_D18.0mm_P7.50mm
C2: 2200uF; CP_Radial_D16.0mm_P7.50mm
C3, C7, C11, C12, C13, C15, C16, C17, C18, C19, C22, C23, C24, C25, C26, C27, C28, C30, C31, C32: 100nF; C_Disc_D5.0mm_W2.5mm_P5.00mm
C4: 10000uF; CP_Radial_D22.0mm_P10.00mm_SnapIn
C5: 4700uF; CP_Radial_D16.0mm_P7.50mm
C6: 330nF; C_Disc_D5.0mm_W2.5mm_P5.00mm
C8: 10uF; CP_Radial_D5.0mm_P2.00mm
C9, C10: 1uF; C_Disc_D5.0mm_W2.5mm_P5.00mm
C14: 47uF; CP_Radial_D5.0mm_P2.00mm
C20, C21: 10nF; C_Disc_D5.0mm_W2.5mm_P5.00mm
C29: 1uF film; C_Rect_L7.2mm_W4.5mm_P5.00mm_FKS2_FKP2_MKS2_MKP2
D1, D2: 1N5822; D_DO-201AD_P15.24mm_Horizontal
D3: SMBJ15A; D_SMB
D4, D6: BZY97C15; D_DO-41_SOD81_P10.16mm_Horizontal
D5, D7, D8: 1N4148; D_DO-35_SOD27_P7.62mm_Horizontal
F1: T3.15A; Fuseholder_Cylinder-5x20mm_Schurter_0031_8201_Horizontal_Op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
H1, H2, H3, H4: M3; MountingHole_3.2mm_M3
J1: PWR_IN; TerminalBlock_Phoenix_MKDS-1,5-2-5.08_1x02_P5.08mm_Horizont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
J2: ARM_ESTOP; Molex_KK-254_AE-6410-04A_1x04_P2.54mm_Vertical
J3: GATE_SENSE; Molex_KK-254_AE-6410-06A_1x06_P2.54mm_Vertical
J4: RELAY_COIL; TerminalBlock_Phoenix_MKDS-1,5-2-5.08_1x02_P5.08mm_Horizont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
J5: FOOT_SWITCH; Molex_KK-254_AE-6410-02A_1x02_P2.54mm_Vertical
J6: OLED; PinSocket_1x04_P2.54mm_Vertical
J7: ENCODER; PinSocket_1x05_P2.54mm_Vertical
LED1: GREEN 5V_AUX; LED_D3.0mm
LED2: YELLOW ARMED; LED_D3.0mm
LED3: RED FAULT; LED_D3.0mm
LED4: GREEN READY; LED_D3.0mm
Q1: BC337; TO-92_Inline_Wide
Q2: BC547; TO-92_Inline_Wide
R1: 1.5R 5W; R_Axial_Power_L20.0mm_W6.4mm_P25.40mm
R2, R23, R25, R27, R29, R30, R32, R33, R35, R41: 1k; R_Axial_DIN0207_L6.3mm_D2.5mm_P10.16mm_Horizontal
R3: 2.2R; R_Axial_DIN0207_L6.3mm_D2.5mm_P10.16mm_Horizontal
R4, R6, R11, R13, R15, R17, R19, R22, R24, R26, R28, R31, R34, R36, R40, R42, R46, R49, R52, R53, R54: 10k; R_Axial_DIN0207_L6.3mm_D2.5mm_P10.16mm_Horizontal
R5: 220R; R_Axial_DIN0207_L6.3mm_D2.5mm_P10.16mm_Horizontal
R7, R20, R21, R43, R48: 4.7k; R_Axial_DIN0207_L6.3mm_D2.5mm_P10.16mm_Horizontal
R10, R12, R14, R16, R18: 33k; R_Axial_DIN0207_L6.3mm_D2.5mm_P10.16mm_Horizontal
R44: 2.2k; R_Axial_DIN0207_L6.3mm_D2.5mm_P10.16mm_Horizontal
R45, R50, R51: 22k; R_Axial_DIN0207_L6.3mm_D2.5mm_P10.16mm_Horizontal
R47: 68k; R_Axial_DIN0207_L6.3mm_D2.5mm_P10.16mm_Horizontal
SW1: ACK / RESET FAULT; SW_PUSH_6mm
TP1, TP2, TP3: GND; TestPoint_Loop_D2.50mm_Drill1.0mm
TP4: VBAT_F; TestPoint_Loop_D2.50mm_Drill1.0mm
TP5: VHOLD_LOGIC; TestPoint_Loop_D2.50mm_Drill1.0mm
TP6: VHOLD_RELAY; TestPoint_Loop_D2.50mm_Drill1.0mm
TP7: +5V_AUX; TestPoint_Loop_D2.50mm_Drill1.0mm
TP8: +5V_MCU; TestPoint_Loop_D2.50mm_Drill1.0mm
TP9: +3V3; TestPoint_Loop_D2.50mm_Drill1.0mm
TP10: VDRV; TestPoint_Loop_D2.50mm_Drill1.0mm
TP11: GATE_CMD; TestPoint_Loop_D2.50mm_Drill1.0mm
TP12: GIN; TestPoint_Loop_D2.50mm_Drill1.0mm
TP13: GATE_OUT; TestPoint_Loop_D2.50mm_Drill1.0mm
TP14: PL_CT; TestPoint_Loop_D2.50mm_Drill1.0mm
TP15: UV_SENSE; TestPoint_Loop_D2.50mm_Drill1.0mm
TP16: DRAIN_BUS; TestPoint_Loop_D2.50mm_Drill1.0mm
TP17: TEMP_ALERT; TestPoint_Loop_D2.50mm_Drill1.0mm
U1: Arduino Nano V3 (ATmega328P); Arduino_Nano
U2: 7805; TO-220-3_Vertical
U3: LM393; DIP-8_W7.62mm_Socket
U4: TC4422CPA; DIP-8_W7.62mm_Socket
U5: 74HCT14; DIP-14_W7.62mm_Socket
U6: MCP1700-3302E/TO; TO-92_Inline_Wide
U7: MCP9804; MSOP-8_3x3mm_P0.65mm

Connections:
+3V3: C10.1, C25.1, J6.1, R20.1, R21.1, R36.1, TP9.1, U6.3, U7.8
+5V_AUX: BZ1.1, C7.1, C8.1, C9.1, C28.1, D7.1, J7.2, R2.1, R22.1, R24.1, R26.1, R28.1, R40.1, R49.1, R53.1, TP7.1, U2.3, U5.14, U6.2
+5V_MCU: R34.1, TP8.1, U1.27
ACK_ACT: U1.9, U5.10
ACK_RAW: R28.2, R29.1, SW1.1
ACK_RAW_F: C23.1, R29.2, U5.11
ADC_NTC: C24.1, R34.2, R35.2, U1.25
ADC_VBAT: C15.1, R10.2, R11.1, U1.19
ADC_VDRAIN: C16.1, R12.2, R13.1, U1.20
ADC_VDRV: C18.1, R16.2, R17.1, U1.22
ADC_VELEC: C17.1, R14.2, R15.1, U1.21
ADC_VHOLD: C19.1, R18.2, R19.1, U1.26
AREF: C11.1, U1.18
ARM_A_DIV: C27.1, R42.2, R43.1, U5.13
ARM_A_N: U1.15, U5.12
BUZZER_CMD: R30.1, U1.11
BZ_N: BZ1.2, D7.2, Q2.1
D5_K: D5.1, D6.1
DRAIN_BUS: J3.3, R12.1, TP16.1
ELEC_POS: J3.4, R14.1
ENC_A: U1.5, U5.2
ENC_A_RAW: J7.5, R22.2, R23.1
ENC_A_RAW_F: C20.1, R23.2, U5.1
ENC_B: U1.6, U5.4
ENC_B_RAW: J7.4, R24.2, R25.1
ENC_B_RAW_F: C21.1, R25.2, U5.3
ENC_SW: U1.7, U5.6
ENC_SW_RAW: J7.3, R26.2, R27.1
ENC_SW_RAW_F: C22.1, R27.2, U5.5
FOOT_ACT: U1.8, U5.8
FOOT_RAW: J5.1, R40.2, R41.1
FOOT_RAW_F: C26.1, R41.2, U5.9
GATE_CMD: D8.1, R44.1, R47.1, TP11.1, U1.12
GATE_DRV: R3.1, U4.6, U4.7
GATE_FB: R46.2, U1.14
GATE_OUT: D4.1, J3.1, R3.2, R4.1, TP13.1
GIN: R44.2, R45.1, R46.1, TP12.1, U3.1, U3.7, U4.2
GND: C1.2, C2.2, C3.2, C4.2, C5.2, C6.2, C7.2, C8.2, C9.2, C10.2, C11.2, C12.2, C13.2, C14.2, C15.2, C16.2, C17.2, C18.2, C19.2, C20.2, C21.2, C22.2, C23.2, C24.2, C25.2, C26.2, C27.2, C28.2, C29.2, C30.2, C31.2, C32.2, D3.2, D4.2, J1.2, J3.2, J3.6, J5.2, J6.2, J7.1, LED1.1, LED2.1, LED3.1, LED4.1, Q1.3, Q2.3, R4.2, R6.2, R11.2, R13.2, R15.2, R17.2, R19.2, R31.2, R43.2, R45.2, R50.2, R52.2, R54.2, SW1.2, TP1.1, TP2.1, TP3.1, U1.4, U1.29, U2.2, U3.4, U4.4, U4.5, U5.7, U6.1, U7.4, U7.5, U7.6, U7.7
LED1_A: LED1.2, R2.2
LED2_A: LED2.2, R7.2
LED3_A: LED3.2, R32.2
LED4_A: LED4.2, R33.2
LED_FAULT_CMD: R32.1, U1.13
LED_READY_CMD: R33.1, U1.16
NTC_HS: J3.5, R35.1
PL_CT: C29.1, R47.2, R48.1, TP14.1, U3.2
PL_DIS: D8.2, R48.2
PL_VTH: R49.2, R50.1, U3.3
Q1_B: Q1.2, R5.2, R6.1
Q2_B: Q2.2, R30.2, R31.1
RELAY_COIL_N: D5.2, J4.2, Q1.1
RELAY_EN: R5.1, U1.10
SCL: J6.3, R21.2, U1.24, U7.2
SDA: J6.4, R20.2, U1.23, U7.1
TEMP_ALERT: R36.2, TP17.1, U7.3
UV_SENSE: C30.1, R51.2, R52.1, TP15.1, U3.5
VBAT_F: D3.1, F1.2, R1.1, R10.1, TP4.1
VBAT_IN: F1.1, J1.1
VDRV: C13.1, C14.1, J2.4, R7.1, R16.1, R51.1, TP10.1, U4.1, U4.8
VHOLD_LOGIC: C1.1, C2.1, C3.1, C6.1, C12.1, C32.1, D1.1, J2.3, R18.1, TP5.1, U1.30, U2.1, U3.8
VHOLD_RELAY: C4.1, C5.1, D2.1, J2.1, TP6.1
VREF_2V5: C31.1, R53.2, R54.1, U3.6
VRELAY_ARM: D6.2, J2.2, J4.1, R42.1
VTAP: D1.2, D2.2, R1.2
