konpdan25/Arduino_Spot_Welder_V4/(commit log)

2026-10-12 DIY_SPOT_WELDER_V1: calculation model, SPICE sims, generated KiCad project
    - Python engineering model (current envelope, MOSFET thermal, hold-up,
    pulse-limiter Monte-Carlo, ADC scaling, cable/fuse I2t)
    - ngspice behavioural sims: weld-loop turn-off with/without free-wheel
    diode, hardware pulse limiter + UVLO
    - Single-source design.py -> hierarchical schematic (10 sheets), project
    symbol/footprint libraries, preliminary routed 2-layer control PCB
    - Netlist parity check vs. kicad-cli export (PASS), KiCad 7 DRC report
    Claude-Session: https://claude.ai/code/session_01DSEKTYjKaoiPHPxSrVUA9J
    [02_POWER_INPUT_AND_PROTECTION.kicad_sch, 03_CONTROL_AND_TIMING.kicad_sch, 04_SWITCHING_AND_GATE_DRIVE.kicad_sch, 05_RELAY_CONTROL_AND_ISOLATION.kicad_sch, 06_CURRENT_VOLTAGE_SENSING.kicad_sch, 07_OLED_AND_USER_INTERFACE.kicad_sch, 08_TEMPERATURE_MONITORING.kicad_sch, 09_TRIGGER_AND_INTERLOCKS.kicad_sch]
2026-10-12 DIY_SPOT_WELDER_V1: firmware (core, sequencer, AVR HAL, UI) + host test harness
    - Hardware-independent weld-enable state machine with latched faults,
    boot self-test (UVLO), arming self-test of the RC pulse limiter with the
    relay open, stuck-current detection, thermal derating, duty limit
    - Timer1-ISR pulse sequencer with compile-time hard limits (50 ms main)
    - AVR HAL: Optiboot reset-cause capture, early WDT disable, gate LOW in
    .init3, watchdog, EEPROM settings + fault log
    - Compiles for ATmega328P (26.3 kB flash, 553 B static RAM)
    - Host tests with simulated plant and fault injection: 29 tests, 0 failures
    Claude-Session: https: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
    [06_CURRENT_VOLTAGE_SENSING.kicad_sch]
2026-10-12 DIY_SPOT_WELDER_V1: BOM, architecture/calculation/safety/manufacturing docs, checklists
    - BOM/MASTER_BOM.csv generated from design.py (STOCK/PURCHASE/UNVERIFIED/REJECTED)
    - Docs 02 architecture comparison, 03 electrical calculations, 04 safety
    risk register + FMEA, 05 manufacturing/assembly, datasheet index
    - OPEN_ISSUES, RELEASE_CHECKLIST, DEVELOPMENT_LOG, README, report index
    - SPICE limiter netlist aligned with final component values
    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
    [02_POWER_INPUT_AND_PROTECTION.kicad_sch, 05_RELAY_CONTROL_AND_ISOLATION.kicad_sch, 06_CURRENT_VOLTAGE_SENSING.kicad_sch, 07_OLED_AND_USER_INTERFACE.kicad_sch, 08_TEMPERATURE_MONITORING.kicad_sch, 09_TRIGGER_AND_INTERLOCKS.kicad_sch, MASTER_BOM.csv]
2026-10-12 Record user decision: proceed with RT1270 as welding source (variant P1)
    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
